matthewmhong/stewart-platform/README.md

# stewart-platform

A 6-RSS (rotary servo) Stewart platform, designed from the kinematics up, built,
and driven from a joystick; the goal is to balance a ping-pong ball on it.  The
repo holds the geometry, closed-form inverse and numerical forward kinematics,
a requirements checker, the Arduino firmware and the PC control code.

<p align="center">
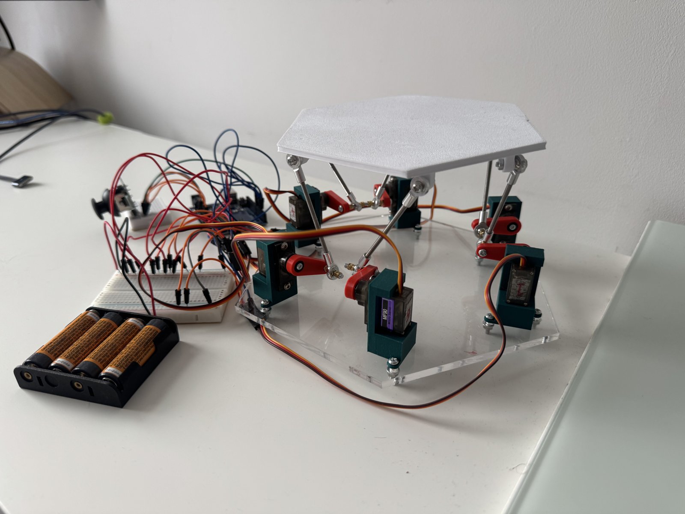
[picture p1: docs/img/build.jpg]
The assembled platform: six servos in green brackets on a clear acrylic base, rods up to a white hexagonal top plate, with the Arduino, joystick, breadboard and AA battery pack beside it
  
</p>

The stage 1 build, October 2026.  The six MG90S servos sit in printed PLA+
brackets on a laser-cut 5 mm acrylic base, and the top plate is printed PLA.
An Arduino Uno reads the joystick and drives the servos from 4× AA.

**Where it stands.** The platform is built and driven from a joystick (stage
1).  The kinematics are done and tested, the servos are bench-measured and
calibrated, and the geometry was chosen because it passes every requirement:

    r_b = 80, beta = 10, delta = 0, r_p = 70, beta_p = 35, a = 22.5, d = 70

Requirements are derived from the ball rather than picked: a 50 mm disturbance
recovered in 0.7 s and held to ±8 mm gives tilt range ≥ 4.5°, tilt precision
≤ 0.25°, tilt speed ≥ 65°/s and loop latency ≤ 70 ms.  `stewart/performance.py`
checks a candidate against those with the real kinematics, plus rod-end
misalignment and part-to-part clearance.

Stage 1 runs IK on the PC and sends six pulse widths to an Arduino over USB
serial.  The first joystick run was on 2 October 2026.  `motion.py` exercises
one degree of freedom at a time.  The measured envelope is roll 9.0°, pitch
9.8° and heave 11 mm, limited by the servos, and yaw 3° and surge/sway 3 mm,
limited by the rod-end cone.  The tilt the plate actually reaches has not been
measured yet, so R1-R3 are still predictions.  Measuring them is next, then
stage 2: a camera and closed-loop balancing.
Details in [STATUS.md](STATUS.md); the reasoning, including the wrong turns, is
in [docs/design-log.md](docs/design-log.md).

<p align="center">
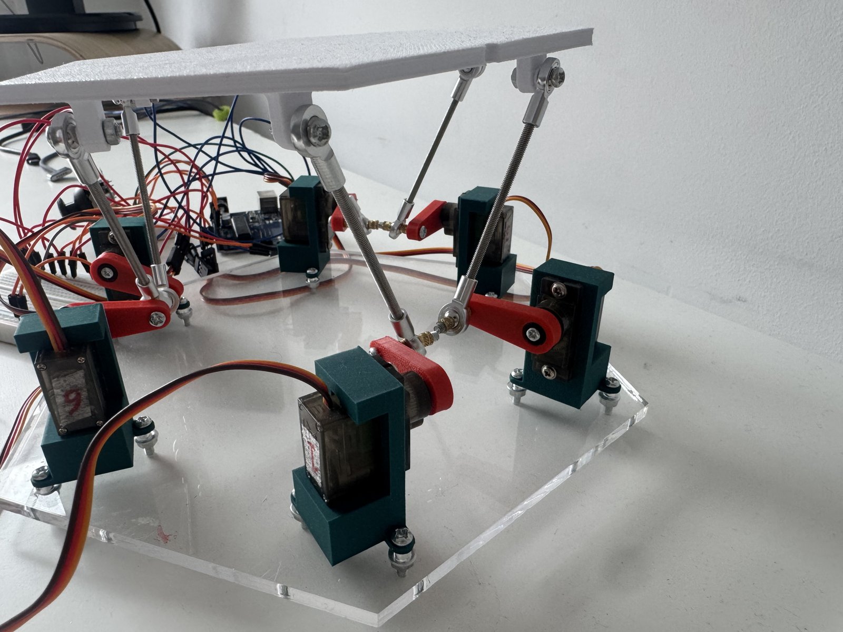
[picture p2: docs/img/build-closeup.jpg]
Close-up of the legs: red printed arms on the servo horns, M3 rod ends spaced off the arms on brass threaded inserts, rods up to the top-plate anchors
  
</p>

Each red arm is printed over the servo's stock horn, so the moulded spline
still sets its angle, and carries an M3 rod end at 22.5 mm.  The brass threaded
inserts on either side of each ball space it off the arm, which lets the joint
swing to about 30° with a straight bolt.

<p align="center">
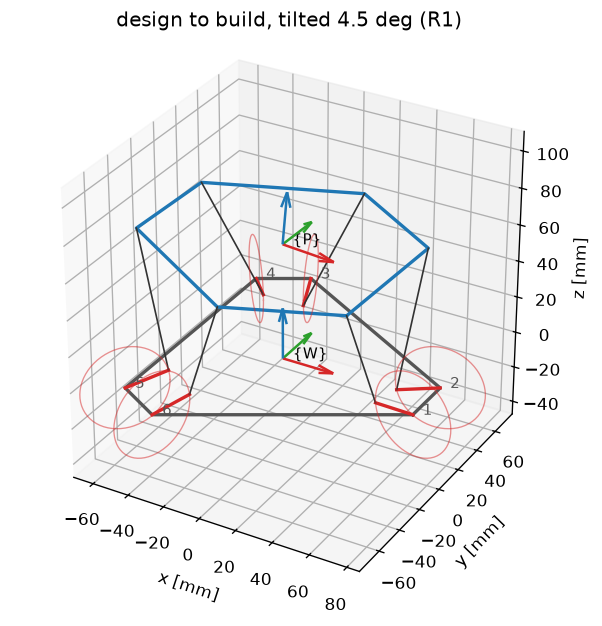
[picture p3: docs/img/design-tilted.png]
The design to build, tilted 4.5 degrees: base ring, servo arms, rods and platform
  
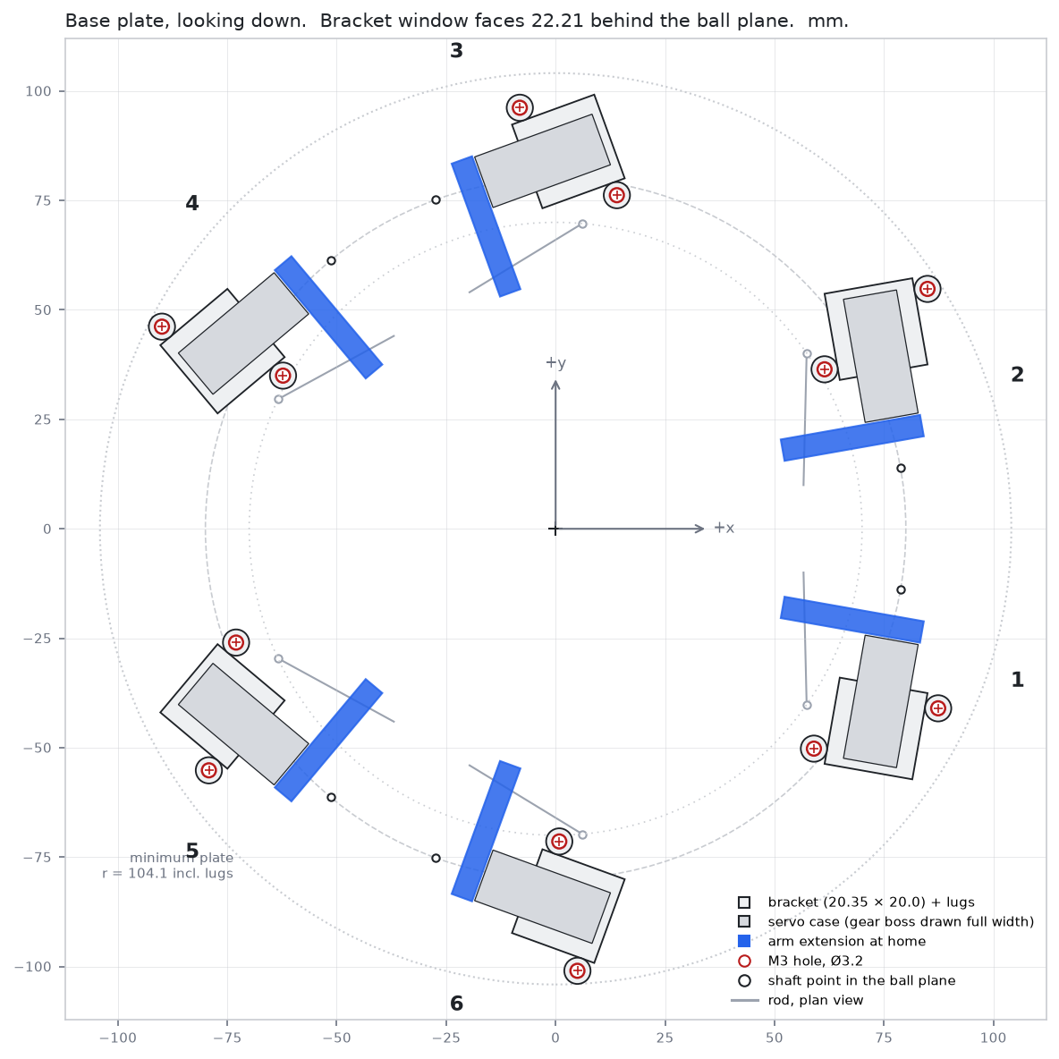
[picture p4: docs/img/base-layout.png]
Base plate from above: six servos in brackets, arm extensions and the twelve M3 holes
  
</p>

Left: the design to build at 4.5° of tilt (R1), from `demo.py`.  Right: the
base plate from above, with servos, brackets, arms and the twelve M3 holes, from
`layout.py`.

## Conventions

- **Millimetres and radians** internally.  Degrees appear only when printing a
  summary or building a servo command.
- **Every anchor array is `(3, 6)`; column `i` is leg `i`.**  Vectors are
  columns and rotations hit from the left: `R @ p`, never `p @ R`.  A `(6, 3)`
  array will broadcast in many places and silently apply the rotation
  transposed, so shapes and unit norms are checked at construction and failing
  legs are named 1-indexed.
- Pose order is `(R, T)` in every signature.
- Python 3, **numpy + matplotlib**; `joystick.py` and `motion.py` also need pyserial.

## Run

    python -m pip install -r requirements.txt
    python test_kinematics.py                  # unit checks
    python demo.py                             # evaluates the design, writes demo.png, round-trips ik/fk
    python layout.py                           # base-plate plan and M3 hole positions -> base-layout.png
    python joystick.py                         # drive the tilt from the joystick (--selftest: no hardware)
    python motion.py                           # oscillate one DOF at a time (--selftest: no hardware)
    python tilt_test.py                        # measure the plate's tilt against commanded (--selftest: no hardware)

## Layout

    stewart/
      geometry.py        Geometry, base_ring, platform_ring, make_geometry
      kinematics.py      stage1, legs, arm_tips, ik, fk (+ Jacobian, solver)
      performance.py     R1-R3, rod-end cone and clearance against one design
      plotting.py        drawing only - never solves kinematics
      roundtrip.py       pose -> ik -> fk -> pose harness
    test_kinematics.py
    demo.py              the design to build: evaluate, draw, round-trip
    layout.py            base-plate plan: servos, brackets, drill holes
    joystick.py          stage 1: joystick -> tilt -> ik -> pulse widths over serial
    motion.py            one-DOF oscillations (roll/pitch/yaw/surge/sway/heave)
    tilt_test.py         holds commanded tilts to read with a level; R1 and R2 on the machine
    firmware/
      servo_test/        Arduino bench-test sketch for one MG90S
      servo_cal/         six-servo calibration: per-leg zero and direction, in EEPROM
      joystick/          streams the stick, outputs the six pulses, fails safe to level
    docs/                derivation, design log, hardware specs, figures
    archive/             frozen: old docs, Phase 0 diagnostics and sweep outputs

## Documents

| file | what it is |
|---|---|
| [STATUS.md](STATUS.md) | requirements, open items, next steps - edited in place |
| [docs/derivation.md](docs/derivation.md) | the maths, and the symbol glossary (§1) |
| [docs/design-log.md](docs/design-log.md) | dated narrative of the design work and why |
| [docs/hardware.md](docs/hardware.md) | specs for the arm extension, servo bracket and top-plate anchors |
| [archive/](archive/) | superseded material, frozen |
