matthewmhong/stewart-platform/archive/README.md

# Archive

Frozen. Not maintained, and may contradict the current docs.

- `docs/` — old session handoffs, one-off Claude Code reports, the repo
  inventory, the full dated notation log, and the 4–10 September design-log
  entries (`design-log-phase0-sweep.md`), and the Phase 0 parts survey that
  used to open `docs/hardware.md` (`hardware-pull-2026-09-09.md`).
- `diagnostics/` — the Phase 0 diagnostic scripts, including the reach-margin
  sweep. They were written as the package `stewart.diagnostics`, so they no
  longer run from here; check out a commit before 2026-09-13 to run them.
- `sweep-outputs/` — the sweep's `.npz`, report and plots (untracked, local
  only).

Superseded on 2026-09-13 by the requirements-driven approach in `STATUS.md`.
For symbols read `docs/derivation.md` §1.
