matthewmhong/stewart-platform/docs/phase-0-design-log.md

# Stewart Platform — Design Log

**Phase 0: kinematics and design method.** A 6-DOF parallel manipulator built as a
ball-balancing platform. Six rotary servos, rigid arms, fixed-length push rods.
100 hours budgeted across the project.

A chronological record of the design work: the reasoning, the decisions and why I
made them, the mistakes, and the results. Dates are the order things were actually
worked out, not a retrospective tidy-up.

---

## 19–20 August

### The decision that shaped the project

The project brief I started from wasn't my own, and I hadn't internalised it.
Tested on six questions about the mechanism at the outset, I could answer none. I
did not know what a pose was, or what a degree of freedom was.

What I decided to do about that shaped everything since. Carrying an unexamined
plan through to a built machine would leave me unable to answer the only question
that matters about a mechanism design: *why this geometry?* A demonstrator I can't
defend is worth less to me than no demonstrator.

So I fixed the method before any of the engineering: derive the kinematics myself,
in symbols, and let the mathematics produce the dimensions — rather than choosing
dimensions and constructing a justification afterwards.

One rule follows from that and I've held to it since: **nothing is purchased and
no CAD is drawn until the geometry sweep has chosen the dimensions.** Every number
in the eventual build has to be traceable to the analysis.

### The mechanism

Six legs connect a fixed base to a moving platform. Each leg is a servo bolted to
the base, a rigid arm on the servo shaft, and a push rod of fixed length running
from the arm tip to an anchor point on the platform. Six servo angles in, one
platform pose out.

A *pose* is position plus orientation: three numbers for where the platform centre
sits, three for how it's tilted. Six inputs, six outputs — hence six degrees of
freedom.

Two frames are needed throughout:

| | |
|---|---|
| `{W}` | World frame. Fixed to the base and the table. Never moves. |
| `{P}` | Platform frame. Attached to the moving plate; tilts with it. |

Labelling every vector with the frame it's expressed in turned out to be the
single most valuable habit I adopted, and its absence caused my first real error.

There's an asymmetry in this class of mechanism worth stating early, because it
shapes the whole approach. For a *parallel* manipulator the inverse kinematics —
pose in, joint angles out — has a closed-form solution, while the forward
kinematics does not and has to be solved numerically. That's the reverse of the
serial-arm case most people meet first.

### Stage 1: locating the platform anchors

The platform anchors are holes in a printed ring. Their coordinates in `{P}` are
fixed design constants, denoted `p_i`. Their coordinates in `{W}` change whenever
the platform moves.

My first instinct was to add the platform centre position `T` to `p_i`
componentwise. Working out why that's wrong was the moment the frame concept
became concrete for me: one unit along the world x-axis is not one unit along the
platform's x-axis unless the platform happens to be level. The two vectors are
measured against different rulers, and the rotation matrix `R` is what reconciles
them — it converts a vector's `{P}` components into `{W}` components.

```
q_i  =  T  +  R p_i
```

I checked it two ways before proceeding. With `R = I` the expression must collapse
to plain vector addition, and it does. With `T = 0` and a 90° rotation about z, an
anchor must swing to a position I can confirm by hand, and it does.

### Stage 2 geometry: circle meets sphere

The servo arm swings in a fixed plane, so the arm tip is confined to a **circle**
of radius `a` centred on the servo shaft.

The push rod is rigid, so the tip is always exactly `d` from the platform anchor —
a **sphere** of radius `d` centred on `q_i`.

The arm tip is wherever the two surfaces meet. Three cases follow, and I worked
out all three geometrically before attempting any algebra:

- **Two intersections** — the general case. The arm can be swung either way to
  place the tip correctly.
- **One** — circle tangent to sphere. The limit of that leg's reach.
- **None** — the leg can't reach. This happens two distinct ways: the anchor too
  far for arm and rod to span between them, or too close, with the circle sitting
  entirely inside the sphere.

The third case is what will define the machine's workspace boundary. Any pose in
which any one leg has zero solutions is a pose the platform physically cannot hold.

### The leg vector, and a productive dead end

This took several attempts and was the hardest part of the first session.

I went looking for a single global reference point for the machine as a whole. I
tried the world origin, then treating the platform as one rigid body, then the
centroid of the six servo positions — which felt clever at the time and leads
nowhere. The reason it leads nowhere is the useful part.

The resolution: **the inverse kinematics is six completely independent problems.**
Leg 3's geometry makes no reference to servos 1, 2, 4, 5 or 6, nor to the base as
a whole. Six separate problems that share only the pose they start from. Leg *i*'s
circle is centred on servo *i*'s own shaft and nothing else.

Once that's established, only two points matter for leg *i*: the anchor `q_i` and
the shaft `b_i`. And since the geometry is unchanged if the whole machine is
carried across the room, what matters is neither absolute position but the vector
between them:

```
L_i  =  q_i  -  b_i  =  T  +  R p_i  -  b_i
```

An important distinction I nearly missed: `|L_i|` is **not** the rod length. It's
the distance the arm and rod have to span *together*. Dividing that span between
them is precisely the stage 2 problem.

### Sizing the problem before solving it

Four quantitative results, produced to establish what the machine actually has to
do before I chose any dimensions.

**Minimum tilt to arrest the ball: 1.635°.** By energy method, for a 200 mm/s ball
brought to rest within 100 mm of travel.

I'm treating that figure carefully. It's a *minimum*, not a design target — what's
required with zero margin, assuming no latency, no friction variation and no
external disturbance. Designing to it is designing to fail. It's a floor to stay
well clear of, and the actual target with justified margin is still mine to set.

**Ball travel during a 150 ms latency window at 300 mm/s: 45 mm.** On a plate of
this size that's a substantial fraction of the working area, which establishes
that control latency is a first-order concern rather than a refinement.

**Worst-case leg force is not a live constraint.** The ball is 2.7 g. No plausible
geometry will leave the servos struggling to support it. I ruled it out early so I
wouldn't spend more time on it.

**The result that most changed how I'm approaching the sweep.** How many
distinguishable tilt steps does the platform have? It's usable servo travel
divided by servo deadband. The geometry ratio — how much platform tilt results
from one degree of servo rotation — appears in both numerator and denominator and
**cancels**.

The consequence isn't obvious and it reframes the whole optimisation: geometry
does not determine how many tilt steps I get. It determines how they're *spent* —
a wide tilt range with coarse steps, or a narrow range with fine ones. There's no
geometry that offers "more control" in the resolution sense; that quantity is
fixed by the servo. The design problem is choosing where to spend a fixed budget
of resolution, which is a very different question from the one I started with.

One process note. Partway through the analysis a 300 mm/s ball speed appeared in
my working with no traceable source. I stopped and asked where it came from rather
than building on it.

---

## 28 August

### Why there is software at all

Before writing any code I wanted to be explicit that the software isn't an
implementation of a finished design. It has three jobs, and only the third
resembles what people usually mean by "the code".

**It's how the geometry gets chosen.** A design sweep means: generate candidate
dimensions, run the inverse kinematics across a grid of poses, score the result,
and repeat some thousands of times. That requires an IK I can *call*. Symbolic
results on paper can't be swept. The Python is therefore a design instrument — the
mechanism by which my derivation becomes the numbers I order parts against.

**It's how I find out the derivation is wrong.** The round-trip test runs a pose
through the IK to six servo angles, then through a numerical forward kinematics
back to a pose. If the pose returns, the mathematics is self-consistent. If it
doesn't, there's a sign or frame error — found now, rather than after I've cut six
push rods to a length computed from a bad equation.

**It's the debugger.** A transposed rotation matrix produces entirely plausible
numbers and a platform that tilts the wrong way. That's visible in one frame of a
3D wireframe and effectively invisible in a column of floats.

### Establishing what is and is not a design variable

The complete list of quantities a leg's inverse kinematics consumes: the platform
anchor positions `p_i`, the servo shaft positions `b_i`, the arm length `a`, the
rod length `d`, and the orientation of each servo's rotation plane. Nothing else
about the machine enters the calculation, so those are my design variables and
there are no others.

I can't sweep them as raw numbers. Six anchors at three coordinates each, twice
over, is thirty-six values before `a` and `d` are counted. A thirty-eight
dimensional search isn't a sweep. The anchors therefore need a *parameterisation*
— a small set of controls that generate all six positions from structure I can
defend. Three or four is tractable; twelve isn't.

Two further distinctions I recorded so I don't conflate them later:

- `a` and `d` are different kinds of variable. `a` is restricted to servo horns
  that commercially exist — a small discrete set. `d` I cut to length myself and
  it's effectively continuous.
- The servo rotation planes are a design variable, not fixed scenery. Which
  direction each servo faces changes what the mechanism can do. Easy to overlook
  because, unlike the others, it isn't a length.

### Conventions

Fixed deliberately and early, since convention errors in this domain are silent:

- **Millimetres and radians** throughout the code. Degrees appear only when
  printing or building a servo command. Units checked on every line — I added a
  rotation to a radius once.
- **Column vectors.** Anchors stored as (3, 6) arrays with column *i* being leg
  *i*. This matters more than it appears: stored row-wise as (6, 3), the
  expression `p @ R` executes without error and returns a result in which every
  value is wrong, because it applies the rotation transposed and tilts the
  platform backwards. No exception is raised. The correct form is `R @ p`.
- **Every equation tested on a known case** at the moment it's written, not at the
  end. `R = I`, `T = 0`, 90° about z.

### Stage 1 in code

```python
return R @ geom.p + T.reshape(3, 1)
```

The reshape is load-bearing. `T` arrives with shape (3,), and numpy would attempt
to align it against the last axis — the six legs — rather than the three spatial
components. Forcing it to (3, 1) broadcasts it across the columns as intended. The
matrix product handles each anchor independently: (3,3) @ (3,6) yields column *i*
as `R p_i`.

Verified against both known cases. `R = I, T = 0` returns the design constants
unchanged; a 90° rotation about z sends an anchor at (10, 0, 0) to (0, 10, 0),
confirming `R` isn't transposed.

The leg vector follows. I wrote it in terms of the stage 1 function rather than
expanding it inline, so a change propagates and there's a single place to make a
sign error:

```python
return stage1(geom, T, R) - geom.b
```

### Locating the arm tip

This is the forward half of stage 2 and the expression the closed form inverts.

The observation that makes it tractable: the arm tip position `h_i` appears to be
three unknown numbers, but it isn't. The tip is confined to a circle, and **a
point on a curve requires one number to specify**. That number is the servo angle
— which is the quantity I'm solving for in any case. The two circle constraints
are therefore not solved but *spent*, collapsing `h_i` from three unknowns to a
function of one.

Writing it down requires a coordinate system inside the servo's plane, expressed
in world components. The plane is tilted in general, so the world x and y axes
won't serve. I need two perpendicular unit vectors lying in the plane:

- `u_i` — the direction I define as `alpha_i = 0`. A free choice.
- `v_i = n_i × u_i` — the cross product with the plane's normal. Perpendicular to
  `n_i` and therefore lying *in* the plane, perpendicular to `u_i`, and of unit
  length because both inputs are unit and mutually perpendicular.

Giving:

```
h_i  =  b_i  +  a ( u_i cos alpha_i  +  v_i sin alpha_i )
```

A conceptual error on the way to this, worth recording because I suspect it's a
common one. I first tried to write the bracket as a coordinate triple,
`(u cos α, v sin α, 0)`. That object doesn't exist. A tuple `(x, y, z)` has
meaning only once the basis its numbers are measured against has been fixed
elsewhere; the basis vectors can't appear inside it. And the zero has nowhere to
live — a third component would require a third basis vector, which would be `n`,
and the tip never leaves the plane. The correct object is a **sum of vectors**,
not a triple.

Verified two ways, the second being the one that matters. Every tip is exactly `a`
from its shaft; and at `alpha = 0`, `h` equals `b + a·u`. The distance check alone
can't detect `u` and `n` being swapped, since `n` is also a unit vector — a tip
placed along it is also exactly `a` away, pointing in an entirely wrong direction.

### The closed form

One constraint remained unused and one unknown remained in it.

**Substituting.** Into `|q_i - h_i| = d`, with `h_i` now a function of `alpha_i`,
and grouping `q_i - b_i` back into `L_i`:

```
| L_i  -  a ( u cos alpha + v sin alpha ) |  =  d
```

Two errors here that I had to be corrected on. First, I read the bars as absolute
value and concluded squaring wasn't permitted. They denote vector **magnitude**,
and `|A| = √(A·A)` — so squaring is precisely what removes the root, cleanly,
since both sides are non-negative. Second, I initially wrote the expansion as
`|A - B|² = A² - B²`, which is the difference of two squares and isn't true even
for scalars. The correct expansion:

```
|A - B|²  =  (A-B)·(A-B)  =  |A|²  -  2 A·B  +  |B|²
```

**Expanding.** Taking `|B|²` first, with `B = a(u cos α + v sin α)`. Multiplied out
as a product of two sums, four terms result; `u·u = 1`, `v·v = 1` and `u·v = 0`
kill the two cross terms, leaving `a²(cos² + sin²) = a²`.

That outcome is forced, and recognising it gives me a check worth keeping. `B` is
the servo arm, and the arm's length is `a` regardless of where it points. Had the
algebra produced anything else, something upstream was wrong.

The middle term:

```
L·B  =  a ( L·u cos alpha  +  L·v sin alpha )
```

`L·u` and `L·v` are scalars — the anchor's coordinates *within* the servo's plane
— computable the moment the pose is known, and containing no `alpha`. Sorting
every term into known and unknown is what made the structure of the solution
visible to me.

Assembled and rearranged with the unknowns isolated:

```
d²  =  |L_i|²  -  2a ( L·u cos alpha  +  L·v sin alpha )  +  a²

M cos alpha  +  N sin alpha  =  P

M = L·u        N = L·v        P = ( |L_i|² + a² - d² ) / 2a
```

**Inverting.** A weighted sum of a sine and a cosine at the same frequency
collapses to a single shifted sinusoid. I didn't accept the identity on assertion
— its derivation is short and worth keeping. Treat `(M, N)` as a point in an
abstract plane, unrelated to the servo's plane, and express it in polar form as
`M = C cos φ`, `N = C sin φ`. That's always possible; it's Cartesian to polar and
nothing is lost. Substituting:

```
M cos α + N sin α  =  C cos φ cos α + C sin φ sin α
                   =  C ( cos φ cos α + sin φ sin α )
                   =  C cos( α - φ )
```

The bracket is the cosine difference identity. The unknown now appears exactly
once and the expression inverts directly:

```
C        =  sqrt(M² + N²)
phi      =  atan2(N, M)
alpha_i  =  phi  ±  arccos( P / C )
```

**A trap worth documenting.** I first wrote the phase as `arctan(N/M)`. Its range
is only (−90°, 90°) — half a turn — and the division discards the sign information
distinguishing `(M, N)` from `(−M, −N)`. Roughly half the servos would be 180° out,
presenting on the bench as an apparent wiring fault. `atan2` retains both signs and
covers the full circle.

**The three cases, recovered.** Everything I'd predicted geometrically now appears
as a condition on `arccos` requiring its argument in [−1, 1]:

| | | |
|---|---|---|
| `\|P\| < C` | 2 solutions | circle cuts sphere twice |
| `\|P\| = C` | 1 | tangent — the workspace boundary |
| `\|P\| > C` | 0 | unreachable |

The algebra produced nothing I hadn't already reasoned out with a pencil, which is
the strongest evidence available to me that both are correct.

### Verification

I checked the closed form by running the problem backwards. Six arbitrary servo
angles chosen; the forward map computes the corresponding arm tips; anchors placed
at exactly `d` from each tip; then the closed form asked to recover the original
angles.

It did, on every leg. Five returned on the negative branch and one on the positive
— not a defect in the formula, but the two-solution ambiguity appearing in
concrete form for the first time.

---

## 1 September

### Why the servo planes needed parameterising first

The sweep needs a candidate geometry described by a handful of numbers. Written
raw, the servo rotation planes are six unit normals — eighteen components, and
they sit alongside eighteen more for the platform anchors and eighteen for the
shaft positions. That isn't searchable.

The second reason is the governing rule of the project. Six independently chosen
normals have no answer to *why this geometry?* A generating rule does.

An ordering constraint I hadn't seen until I tried to start: the normals sit on
top of the shaft positions, so whatever symmetry the base layout has, the normal
rule has to respect it. That means the base layout has to be fixed first. Trying
to write the normal rule before deciding the base pattern is assuming a symmetry
that may not exist, which is why the problem felt like it had no entry point.

### The base ring

Three pairs on a threefold orbit, mirror-symmetric within each pair:

```
s_i      = (-1, +1, -1, +1, -1, +1)
theta_i  = 120·floor((i-1)/2)  +  s_i·beta
b_i      = r_b (cos theta_i, sin theta_i, 0)
```

Two parameters, `r_b` and `beta`. The range is `beta ∈ (0°, 60°)` — open at both
ends, because either end collides adjacent servos. `beta = 30°` collapses to the
regular hexagon, which is a useful limiting case to test against rather than a
default to adopt.

### The rule

```
psi_i  =  theta_i  +  90  +  s_i·delta
n_i    =  (cos psi_i, sin psi_i, 0)
```

One scalar, `delta ∈ [0°, 180°)`, generating all six planes. The alternating
`s_i` is what makes the rule mirror-symmetric within each pair, matching the base.

With the in-plane basis fixed as

```
u_i  =  z × n_i          v_i  =  n_i × u_i  =  z
```

since `n_i` is horizontal.

### The 90° is forced, not chosen

I first wrote it as a convenient reference. It isn't a choice. Putting a general
constant in and imposing the mirror condition on a pair:

```
psi_i  =  theta_i + c + s_i·delta

psi_1  =  -beta + c - delta         mirror:  180 - psi_1  =  180 + beta - c + delta
psi_2  =  +beta + c + delta

equal  =>  c = 180 - c  =>  c = 90
```

Only `c = 90` survives, mod 180. `c = 270` is not a second option — it is the same
planes with every normal flipped, giving identical arm circles with `alpha`
relabelled as `180 − alpha`. That is the `delta ↔ delta + 180` redundancy already
accounted for by the half-open range.

**What it buys.** At `alpha = 0`, the tip is at `b_i + a·u_i`, and
`u_i · z = (z × n_i) · z = 0`, so the tip sits exactly at base-plate level. The arm
lies flat. That corresponds to a servo at mid-travel and gives an unambiguous
assembly datum — arms level, checkable by eye against the plate.

### Horizontal shafts, and what the choice pays for

Constraining every shaft axis to lie in the base plane is a decision, not a
consequence. The obvious benefit is manufacturing: servos bolt flat, no brackets.

The non-obvious benefit is that it removes a whole class of failure. Because
`n_i · z = 0`, the vertical direction lies *inside* every servo plane, so the
vertical component of the leg vector passes into the solution intact:

```
N  =  L_i · v_i  =  L_i · z  =  (q_i - b_i) · z  =  q_i · z
```

using `b_i · z = 0` since the shafts sit in the base plane. So `N` is simply the
height of anchor *i* above the base plate, and since

```
C  =  sqrt(M² + N²)  ≥  |N|
```

`C` cannot reach zero unless an anchor is sitting on the base plate itself. On any
machine where the platform stays above the base, the leg cannot lose authority
through `C → 0`. That is established by construction rather than by searching the
parameter space for degenerate values, and it means no region of `delta` needs
excluding.

Worth recording the dependency: this argument rests entirely on `n_i · z = 0`. If
canted shafts are ever revisited, it disappears and the degeneracy question comes
back open.

### Tuning delta

`delta` is chosen, not fixed by symmetry. The objective:

```
J(delta)  =  max over pose envelope, over i, of  |L_i · n_i|
delta*    =  argmin J on [0°, 180°)
```

`L_i · n_i` is the component of the leg vector perpendicular to the servo's plane
— the part the servo has no authority over. It is pure penalty: it never appears
in `C = √(M² + N²)`, but it does contribute to `|L_i|²` and therefore to `P`. So
out-of-plane offset inflates `|P|` while adding nothing to `C`, pushing legs
toward the unreachable condition `|P| > C`. Minimising the worst case across legs
and poses is minimising the tightest reachability constraint on the machine.

No closed form; a 1-D search. Checked against the quantity actually cared about —
the margin `C − |P|` — across the envelope, and the two track.

One structural consequence. `J` needs `L_i`, which needs the platform anchors. So
`delta` cannot be tuned once and frozen; it is an inner optimisation inside the
sweep, run per candidate geometry. Worth knowing before the sweep is written
rather than discovering it when the sweep is slow.

### A correction to the reachability condition

Working on this exposed an error in how I had been thinking about when a leg can
reach. The intuitive condition is the two-sphere one:

```
|d - a|  <  |L_i|  <  d + a
```

That is necessary but **not sufficient**, because the arm tip lies on a circle,
not a sphere. Decomposing the leg vector into in-plane and out-of-plane parts,
`|L_i|² = rho² + w²` with `w = L_i · n_i`, gives `M² + N² = rho²` — the in-plane
part only. The out-of-plane offset `w` appears in `P` but never in `C`.

Concretely, with `a = 20` and `d = 120`: an anchor at `M = 0`, `N = 0`,
`w = 110` has `|L_i| = 110`, comfortably inside `(100, 140)`, and is unreachable —
`C = 0` while `|P| = 1900`.

This closes the item that had been sitting marked *unverified* in the derivation
document: `|P| > C` does catch both failure directions, but the two-sphere bound
is not an equivalent statement of it and must not be substituted for it in code.

### Errors on the way

The first version of the tuning rule was indexed by leg — a `delta_i` per servo,
derived from the direction each leg pointed at home. That defeats the entire point
of the exercise: six numbers is not a parameterisation. The fix was to keep the
one-scalar family and choose the scalar by optimisation over the envelope, rather
than by a per-leg construction.

---

## 4 September

> **Skeleton only — not written up.** The entries below are the factual record of
> what was established, what was withdrawn, and the residuals. Every point marked
> `TODO(him): reasoning` is where this log's other entries carry an explanation of
> *why*, and that explanation is not written yet. Nothing here is in his voice, and
> nothing here should be read as his account of the session until he replaces it.
>
> Sources: `docs/session-handoff-2026-09-04.md`, `stewart-ik-derivation.md` §8/§9/§10,
> `stewart/diagnostics/zhome_datum.py`, `stewart/diagnostics/branch_check.py`.
>
> **Note on ordering.** Several results below reverse other results from the *same
> day*. Where that happens it is stated, with what was replaced. The reversals are
> not tidied away.

### Implemented

- `stage1`, `legs`, `arm_tips`, `w`, `ik`, `Unreachable` in `stewart/kinematics.py`.
  `c_p` threaded through `platform_ring` and `make_geometry`.
- §7 verification table re-established in `test_kinematics.py`, exit 0. Residuals:
  `stage1(R=I,T=0) == p` → 0; `Rz(90)` on `(10,0,0)` → 6.1e-16;
  `|arm_tips(0) - b| == a` → 5.6e-17; `arm_tips(0) == b + a·u` → 0; control row
  `b + a·n` also passes the distance check → 5.6e-17.
- `w()` repointed from an inlined `L_i` to `legs()`; regression over 4000 random
  poses bitwise identical.
- `TODO(him): reasoning` — why the control row was added, and what it shows that the
  distance check alone cannot.

### Established

- **Branch fixed as `-`** for all six legs, resting on `N_i > 0` under horizontal
  shafts. Closest approach to the branch-merge boundary over the provisional
  envelope: **−5.7e-3 of `C`**. Both supporting diagnostics — the 4365-pose sweep and
  the 720-step precession loop — ran at a **single** `z_home`, and that basis is now
  narrower than it was when the branch was fixed (see *Reopened*).
  `TODO(him): reasoning`
- **`z_flat` closed form** (derivation §9), with `g_i = q_i^{xy} - b_i`,
  `A = beta_p - beta`, `G = r_p e^{iA} - r_b`, `delta_G = arg G`:
  `|g|² = r_p² + r_b² - 2 r_p r_b cos A`,
  `g·u = r_b cos delta - r_p cos(A - delta)`,
  `(z_flat - c_p)² = d² - |g|² - a² - 2 a |g| cos(delta - delta_G)`, positive root.
  **Leg-independence is algebraic** — neither `|g|²` nor `g·u` contains `s_i` — and
  needs no D₃ argument. Verified against `make_geometry`, not a rebuilt ring, over
  540 grid points: leg-independence `max_i - min_i` ≤ **9.948e-14** (1.501e-15
  relative); closed form vs library geometry ≤ **1.637e-11** (2.103e-15 relative);
  `max|u_i·z| = 0` exactly. Round-trip confirmation at the derived height with
  `alpha = 0`, `|q_i - arm_tips(0)_i|` against `d`: worst residual **2.220e-16**.
  `TODO(him): reasoning` — including why the D₃ route was not taken.
- **`alpha` at home is one scalar shared by all six legs** (derivation §10). Follows
  from the two residuals above, not a new measurement. Two consequences recorded: all
  six servos read the same angle at home, a by-eye build check; and a non-zero home
  angle is absorbable by horn mounting angle. `TODO(him): reasoning`
- **Inner `delta` objective is the normalised reach margin** `(C_i - |P_i|)/C_i`,
  maximin over legs and envelope poses, superseding `J(delta) = max|w_i|`. The
  division by `C_i` is required for scale invariance. `delta` is absent from `L_i`,
  so `P_i` is `delta`-free and only `C_i` moves; at fixed leg and pose the margin is
  strictly decreasing in `|w_i|`. The two objectives differ **only in aggregation** —
  minimax over `|w_i|` against maximin over the margin. `TODO(him): reasoning`
- **Precompute feasibility bracket**, available because `P_i` is `delta`-free:
  `C_i ∈ [sqrt(|L_i|² - amp_i²), |L_i|]` with `amp_i = sqrt(A_i² + B_i²)`, giving two
  exact delta-free tests. Only the undecided middle pays 180 `delta` steps.
  `TODO(him): reasoning`
- **Compute is a wash, not a win** — correcting an overstatement made in session. The
  datum path was 273M full evaluations; this path is ~7.6M full plus ~1.4e9 cheap
  scan evaluations. Both near 10¹⁰ flops. 1.4e9 floats is ~11 GB, so the scan must
  chunk over candidates. `TODO(him): reasoning`
- **Symmetry structure of the six `w_i`** as the D₃ stabiliser of the pose, verified
  signed with a negative control. **Closed form for `delta*`**,
  `atan2(-r_p sin A, r_b - r_p cos A) mod 180`. `TODO(him): reasoning`
- **`beta_p = beta` is not a rank hole.** True rod lines `q_i - h_i` give full rank 6,
  `sigma_min` monotonic through `e = 0`, scaling linearly in `a` (log-log slope
  0.992). The rank-3 result was a concurrency artifact of the `q_i - b_i` proxy.
  `TODO(him): reasoning`
- **Tilt target does not scale with the kinematics** — `1/k` against translations'
  `k`, so absolute scale re-enters upstream of the sweep. `TODO(him): reasoning`
  — **MOOT 2026-09-08, not wrong.** The tilt target is decided to be a **fixed
  angle**: the ball surface is a bought sheet decoupled from the anchor ring, so
  `x0 = 80 mm` is a property of the sheet and not of `r_b`. **The `k`-dependence
  this entry establishes no longer exists to be established.** Its conclusion —
  absolute scale enters upstream — survives, but on the bed and on `p`'s
  denominator, not on this. See the 8 September entry and `notation.md` sec.9.

### Decided, reversing an earlier decision the same day

- **`z_home = z_flat` is dropped.** `z_flat` remains an **assembly datum only** and is
  no longer identified with the home pose; **`z_home` returns as an outer sweep
  axis**. This replaces the earlier 2026-09-04 decision that `z_home` was determined
  by the flat-arm datum. Propagated: the sweep is **six** normalised axes, not five —
  `beta`, `r_p/r_b`, `beta_p`, `a/r_b`, `d/r_b`, `z_home/r_b`; **15625** candidates at
  5 points per axis, not 3125; `delta ∈ [0°, 180°)` **restored as sufficient**;
  `z_home`'s range **undecided, with nothing currently supplying one**.
  `TODO(him): reasoning` — this is the entry that most needs it: what the datum bought,
  what it cost, and why the cost was judged the larger.

### Withdrawn

- **"8 of 432 grid combinations produce no valid `z_home`, all at `d/r_b = 0.8`, so
  the harness needs a feasibility guard."** An artifact of holding `delta = 40`. All
  8 are feasible on `[180°, 360°)`; **no geometry among them is infeasible**. The
  feasibility-guard requirement it created is struck in both places it appeared.
  `TODO(him): reasoning`
- **"`z_home` is determined, not free, and the sweep is five axes not six."** Per the
  reversal above. `TODO(him): reasoning`
- **`delta*` as an "exact seed … in the right basin."** Correct statement: `delta*`
  zeroes `w_i` at home — the pointwise quantity both candidate objectives are
  monotone in — **at one pose**. It is not the maximiser of the margin aggregate and
  not the minimiser of `J`. **A seed with no basin claim.** The open test is whether
  the margin's maximiser stays within a bracket of it: a question about aggregation,
  not about the function. `TODO(him): reasoning`

### Recorded so it is not reintroduced

- **The flat-arm datum lifts the gauge that makes `delta ∈ [0°, 180°)` sufficient.**
  §8 justifies the half-open range by `n → -n` giving the same planes, which it does
  — but `u = z × n` flips with it, so `alpha = 0` puts the arm on the opposite side.
  Same machine under a relabelling of `alpha`; **different assemblies under a
  flat-arm datum**. Measured with `z_home = z_flat` imposed: **3 of 432** combinations
  are feasible only on `[180°, 360°)`, all three at a simultaneous four-axis grid
  corner (`beta` min, `beta_p` max, `r_p/r_b` max, `d/r_b` min), **so the boundary
  lies outside the sampled region and its extent is unknown**.
- Also: **`delta*` reduced mod 180 returns to `delta_G`**, which is where
  `(z_flat - c_p)²` is **minimised** — under the datum the closed-form seed pointed at
  the tightest-feasibility `delta`.
- `TODO(him): reasoning` — why this is written down at all: the datum is
  algebraically tempting and will be proposed again.

### Reopened by the reversal

- The `-` branch evidence — the 4365-pose diagnostic and the 720-step precession loop
  — was gathered at **one** `z_home` and must be re-run across the restored axis. The
  branch conclusion is not withdrawn; its evidence base is narrower than it read.
- `N_i > 0` now sets the **lower bracket of the `z_home` axis**, not merely a
  docstring-to-test upgrade. `N_i` at home is `z_home - c_p`; tilt drops the low
  anchors by roughly `r_p sin(tilt)`.
- `z_home`'s range: lower from `N_i > 0`, upper from reach `|P| ≤ C`. `z_flat(delta)`
  remains the natural reference for setting the bracket even though home no longer
  sits on it. **Undecided.**
- Hardware pull gains **servo horn spline tooth count / mounting-angle resolution** —
  it decides whether a non-zero home angle costs anything.
- `TODO(him): reasoning`

### Provenance

- `branch_check.py` — the script behind "8 of 432" and the −5.7e-3 boundary margin —
  was **recovered from a session scratchpad, not from the repo**, and committed as
  `stewart/diagnostics/branch_check.py`. It had never been in git history. This is
  the **third** recorded instance of a documented result with no code behind it.
  **Recovered is not the same as never lost.** `TODO(him): reasoning`

---

## 5 September

> Skeleton only, same terms as the 4 September entries above: facts and
> residuals, no prose, nothing in his voice.
>
> Sources: `docs/notation.md` sec.9/10/12, `docs/session-handoff-2026-09-04.md`,
> and the four modules in `stewart/diagnostics/` named below.

**Envelope specified.** `dxy = 0`, `dz = 0`, `yaw = 0`, tilt limit **10.529 deg**.
Bang-bang recovery: `acc = 4 x0 / tau^2`, `sin(tilt) = 7 acc / (5 g)`,
`x0 = 50 mm` working `+ 30 mm` latency drift, `tau = 0.5 s`, `g = 9.80665`.
Bare requirement **6.558 deg** at `x0 = 50 mm`; the 3.971 deg difference is the
latency margin. Both recorded. `TODO(him): reasoning`

- `tau_L = 150 ms` is **provisional**, inherited from the 300 mm/s figure
  withdrawn 2026-09-03. It carries 30 of the 80 mm and 3.97 of the 10.53 deg.
  Needs sensor frame interval plus servo step response. `TODO(him): reasoning`
- Sensitivity: tilt goes as `1/tau^2`; a 10% error in `tau` moves required
  `sin(tilt)` by ~20%. `tau = 0.45` gives 13.038 deg, `tau = 0.60` gives 7.290.
  `TODO(him): reasoning`

**The `1/k` tilt-scaling result is inverted.** Under the arrest framing (fixed
`v`, `L` proportional to `k`) required tilt goes as `1/k`. Under the recovery
framing now adopted, `x0` scales with `k` at fixed `tau`, so `acc` scales with `k`
and **required tilt scales as `k`** - it *grows* with plate size. The conclusion
survives unchanged (absolute scale enters upstream, `r_b` fixed before the sweep);
the mechanism is the opposite sign. `TODO(him): reasoning`

> **MOOT 2026-09-08, not wrong.** Both this entry and the 2026-09-04 entry it
> inverts assumed **`x0` scales with the plate**. Decided 2026-09-08: the ball
> surface is a **bought plastic sheet on a hub, decoupled from the anchor ring**,
> so `x0 = 80 mm` is a property of **the sheet** and the **tilt target is a fixed
> angle — 10.529 deg at every mechanism scale**. There is no longer a
> `k`-dependence for the two framings to disagree about, so neither is corrected:
> the quantity they argue over does not exist. **ASSERTED, not measured.**
>
> What survives: absolute scale does enter upstream. It enters in **exactly two
> places** — the bed (`r_b <= 90 mm`) and `p`'s denominator (the asserted 80 mm
> `r_b` floor) — and **not** through the tilt target. See the 8 September entry
> and `notation.md` sec.9 and sec.12.

**Envelope is two axes, not four.** `dxy = 0` removes `x` and `y`; what remains is
tilt magnitude and tilt azimuth. Being purely angular it carries no length
dimension and does not scale with `k` at all. `notation.md` sec.9's note about
translations forcing the envelope to scale is deleted. `TODO(him): reasoning`
*(Unaffected by the 2026-09-08 decision above: the envelope was already angular,
and a fixed tilt target is what it was already being read as.)*

**Azimuth window - a claim tested and half-refuted.** Claim: a 60-degree azimuth
window suffices by D3. Measured over the full circle at 0.25 deg, four geometries,
two aggregates, with a negative control (one anchor displaced 0.03 `r_b`):

| invariance | worst relative deviation | verdict |
|---|---|---|
| period 120 | 1.026e-13 | holds |
| mirror `psi -> 180 - psi` | 5.648e-14 | holds |
| mirror `psi -> -psi` | 2.303e-01 | **fails** |
| negative control, period 120 | 6.588e-01 | fails as intended |
| negative control, `180 - psi` | 3.736e-01 | fails as intended |

Width right, position wrong: the window is **`[30, 90]`**, not `[0, 60]`. Mirror
lines in azimuth sit at `30 + 60k`, because a reflection in the plane at azimuth
`m` maps a tilt axis at `psi` to one at `2m + 180 - psi`. `[0, 60]` is symmetric
about its own centre and misses the orbit `{75, 105}` entirely.
`stewart/diagnostics/azimuth_symmetry.py`. `TODO(him): reasoning`

**Pose grid.** 5 magnitudes x 7 azimuths, magnitude 0 counted once:
**29 poses, 174 `w` evaluations** per objective evaluation. Supersedes
`notation.md` sec.9's `3^6 = 729` / `4374` and 2026-09-04's 81 / 486.
`TODO(him): reasoning`

**`z_home` lower bracket, closed form.** `z_home > r_p sin(tilt) + c_p cos(tilt)`
`= 0.182733 r_p + 0.983163 c_p` at 10.529 deg. `delta`-free, `a`-free, `d`-free,
because `v_i = z` exactly and `b_i . z = 0` give `N_i = q_i . z`. Verified against
`make_geometry`: `min N_i` at the bound is 0 to **5.551e-17**; `max |v_i - z|`
**1.110e-16**. `TODO(him): reasoning`

- The back-of-envelope `z_home - c_p > r_p sin(tilt)` drops the `cos(tilt)` and
  overstates by `c_p(1 - cos tilt)` = **1.684e-3** at `c_p = 0.1 r_b`.
  Conservative, so it errs safe; not the bound. `TODO(him): reasoning`
- It is a **continuum** bound. A discrete pose grid reports it satisfied before it
  is - **+5.911e-4** on the 29-pose grid at `beta_p = 25`. The harness must take it
  from the formula. `TODO(him): reasoning`

**`z_home` upper bracket, per candidate, from `|P| <= C`.** No closed form. Over
540 candidates (5 `beta` x 4 `beta_p` x 3 `r_p/r_b` x 3 `a/r_b` x 3 `d/r_b`,
`c_p/r_b = 0.1`), `z_home/r_b` scanned 0.025..3.0 at 0.025, `delta` at 1 deg:

- **363 of 540** have a non-empty bracket; 177 empty; **0 non-contiguous**.
- lower ends `[0.225, 1.650]`, upper ends `[0.425, 1.875]`, widest 0.825.
- empty by `a/r_b`: **144 of 180** at `a/r_b = 0.10`, 33 of 180 at 0.20, 0 at 0.35.
- **`N_i > 0` set the lower end in 0 of 363** - but that is a survivorship sample.
  Attributing the 177 empties (2026-09-05): **176 reach-empty alone, 1 where the
  reach ceiling falls below the `N_i` floor** (`beta=10, beta_p=55, r_p/r_b=1.10,
  a/r_b=0.10, d/r_b=0.80`; ceiling `0.2920624` refined by bisection against a floor
  of `0.29932`, gap **`+7.26e-03`**, real and not a grid artifact). And **6**
  candidates have a non-contiguous *reach* set whose spurious low component
  (`z_home ~ 0.025-0.125 r_b`, platform on the base plate) sits entirely below the
  `N_i` floor in 6 of 6 - so `N_i > 0` is what keeps the feasible set an interval.
  Corrected claim: it does not shape the interior and is not why most candidates
  fail, but it is **load-bearing at the edges** and cannot be dropped.
`TODO(him): reasoning`

**`-` branch re-run across the restored `z_home` axis at 10.529 deg.** Fixture A,
`z_home` swept past its bracket both ways, precession over the full circle at
0.25 deg (1440 steps):

| check | result |
|---|---|
| `min(N_i) > 0`, every `z_home` | passes, worst `+0.896361 r_b` |
| envelope fully reachable | 8 of 15 `z_home`, `[1.2000, 1.2875] r_b` |
| branch reaching `alpha ~ 0` at home | `-`, at every feasible `z_home` |
| branch-flip step outliers | **0** |
| loop closure | `<= 1.78e-15` |
| `max abs(ik() - alpha_minus)` | **8.882e-16** |

`TODO(him): reasoning`

**The `-5.7e-3` boundary margin is superseded.** Reproduced exactly
(`-5.713988e-03`) on the old envelope at the datum `z_home = 1.223343`. On the
settled envelope, same geometry, same height: **`+1.550398e-01`**. Tuning `z_home`
alone at fixture A's untuned `delta = 40`: **`+2.276643e-01`** at
`z_home/r_b = 1.2375`. Individual costs, each a difference of two measurements on
one pose set: yaw `+/-10` **1.8033e-01**, translation `+/-0.05 r_b` **3.6486e-01**,
tilt 6 -> 10.529 **3.6147e-01**. The negative figure was bought by yaw and
translation, not by tilt. `TODO(him): reasoning`

- **WITHDRAWN 2026-09-05: the four-row attribution table.** The decomposition does
  not close - baseline `+5.148872e-01` minus tilt cost `3.614680e-01` gives
  `+1.534192e-01` against a settled figure of `+1.550398e-01`, a **1.62e-3**
  discrepancy, ~1% of the quantity the table existed to explain and three orders
  above every other residual recorded here. Cause confirmed: the rows and the
  settled figure are maximins over **different azimuth samples** (magnitude grids
  identical; 15 deg vs 10 deg), so subtracting one from the other was never valid.
  The conclusion is kept - it rests on gaps of `1e-1`, not on the arithmetic.
  `TODO(him): reasoning`
- **The 29-pose harness grid is grid-optimistic.** Same fixture, same height, by
  azimuth sampling: 15 deg `+1.534192e-01`, **10 deg (the settled figure)
  `+1.550398e-01`**, 0.25 deg reference `+1.531859e-01`. The harness grid
  **overstates the margin by ~1.9e-3**. Same failure mode as the `N_i > 0` bound.
  `TODO(him): reasoning`

**Closed:** handoff open items 1, 5, 8 and 11. `TODO(him): reasoning`

### `fk()` and the round-trip gate — the gate passes

> Same terms as above: facts and residuals, no prose, nothing in his voice.
> Source: `docs/cc-fk-gate.md`, `stewart/kinematics.py`,
> `stewart/diagnostics/roundtrip.py`.

**Gate result.** `pose -> ik -> six angles -> fk -> pose`, seeded **HOME**
(`R = I`, `T = (0,0,z_home)`) at every pose. **14 436 poses, 4 geometries, 3
grid levels.** Worst `|T_fk - T_cmd|` **1.853e-13 mm**; worst
`arccos((tr(R_cmd^T R_fk) - 1)/2)` **2.091e-06 deg**. **0** non-convergences,
**0** different-mode returns, **0** `ik` unreachable. `TODO(him): reasoning`

**Jacobian verified; the handed-over form was correct and was not changed.**
`df_i/dT = e_i^T`, `df_i/domega = -e_i^T [R p_i]_x`, left perturbation
`R -> exp([omega]_x) R`. Central differences, 348 samples, 5 step sizes:

| h (mm) | worst entrywise rel. | worst Frobenius |
|---|---|---|
| 5e-2 | 1.609e-05 | 1.076e-05 |
| 5e-3 | 1.609e-07 | 1.076e-07 |
| **5e-4** | **9.552e-08** | 1.078e-09 |
| 5e-5 | 1.568e-06 | 3.916e-11 |
| 5e-6 | 1.142e-05 | 3.869e-10 |

Bottom of the U at `h = 5e-4 mm`, an order above the textbook
`(eps*scale)^(1/3)`, because `|q-h|-d` cancels two ~120 mm quantities.
Negative control, one pose: sign-flipped left **2.000**, right perturbation
**4.307e-01**, right sign-flipped **1.974**, against **9.781e-10** for the
endorsed form — nine orders, so the test discriminates. `[R p]_x = R [p]_x R^T`,
so the right form differs by an `R^T` as well as a sign. `TODO(him): reasoning`

**The tolerance is an acceptance test, not a stopping rule.** First version got
this wrong. With `tol` as the stopping rule the required demonstration is
structurally impossible: ~40% of poses halt on the first iterate that crosses it
(48 of 117, fixture A at `1e-9`), so a max over a grid is taken over exactly
those, and worst `|dT|` tracks `tol` linearly — **9.7e-10, 1.3e-10, 1.7e-11,
1.8e-12, 1.3e-13 mm** at `tol = 1e-9 .. 1e-13`. `fk` now stops on **stagnation**
and applies `FK_TOL_MM = 1e-9 mm` **once**, to the converged residual. Worst
`|dT|` then **1.2681e-13 mm at every tolerance from `1e-8` to `1e-13`** — zero
movement across six decades. Acceptance fails at `1e-14` (234 poses), which is
below the measured arithmetic floor of **1.4e-14 to 7.1e-14 mm**.
`TODO(him): reasoning`

**Characteristic length not picked; sec.12 stays open.** All `cond` and
`sigma_min` quoted at `r_b` and flagged PROVISIONAL. Worst `cond` over the
coarse grid, by candidate length:

| fixture | `r_b` | `r_p` | `d` | `a` |
|---|---|---|---|---|
| A | 4.183 | 4.175 | 4.20 | 12.81 |
| C | 3.712 | 3.075 | 4.05 | 3.737 |
| E | 7.397 | 6.285 | 6.695 | 7.185 |
| F | 6.317 | 6.365 | 6.54 | 19.51 |

Spread a factor of 3 on F. LM damping is `lam*diag(J^T J)`, not `lam*I`, which
would add a millimetre to a radian and so need exactly that length.
`TODO(him): reasoning`

- Residual-to-pose-error conversion **checked per pose, not asserted**:
  `||dx|| <= sqrt(6)(max_i|f_i| + eta)/sigma_min`, worst measured/bound
  **0.074**. Three corrections were needed: maxima from different poses do not
  multiply into a bound; the bound is on `||f||_2` so `max_i|f_i|` needs
  `sqrt(6)`; and `eta = 8 eps (d + |T|)`, the round-off in *evaluating* a
  residual, must be added — at the floor it is the same size as the residual.
  Without `eta` the check reads **1.535**, i.e. violated. `TODO(him): reasoning`

**Assembly modes are real.** 0 different-mode returns from the home seed. Because
that is equally consistent with "the classifier never fires", the same six angles
were re-solved from **400 random seeds per fixture**: **8 distinct roots each,
32 in all**, every one at the same arithmetic floor (`1.42e-14 mm`) as the
commanded root — **the residual cannot separate them**, which is why the gate
classifies on pose distance. Of 28 non-commanded roots: **1** has all anchors
above the plate, **0** are inside the tilt envelope. The other 27 have
`min q_z < 0`, violating `N_i > 0`. `TODO(him): reasoning`

- A genuine nearby-mode case exists on `smoke_geometry` (`demo.py`'s "yaw +90"
  row): `|dT|` **0.3163 mm**, ang **0.7296 deg**, residual **1.421e-14**, and
  `ik` at the recovered pose returns the **same six angles to 2.0e-13 deg**. It
  sits at `cond` **9045**, `sigma_min` **1.94e-4** (at `r_b = 90`) against `cond`
  4–10 on the real fixtures. Near-singular geometry is where modes coalesce and
  a pose-distance classifier would call a second root a failure.
  `TODO(him): reasoning`

**Grids, and the refinement question.** Coarse/medium/fine at `(5,7,3)`,
`(9,13,5)`, `(17,25,9)` magnitudes x azimuths x `z_home`; coarse is
`envelope.py`'s own 29-pose harness grid. `z_home` sampled in the bracket
**interior**. Worst case **does move** under refinement — 1.47x, 1.14x, 1.29x,
1.46x, monotonic on 3 of 4 fixtures — so a coarse grid flattered it in the unsafe
direction a fourth time. But 40x the poses buying 1.5x in the max is sampling a
fixed round-off distribution at `1e-13 mm`, not finding a worst case. **Open item
12 is unaffected**: this gate has no dynamic range to bear on it.
`TODO(him): reasoning`

**Iteration counts, home seed.** Median **5** on all four fixtures, max **8**,
min 4; cap 100. **Home seed failed to converge at 0 poses** — no basin finding.
LM steps *accepted* 36 / 60 / 246 / 289 of 3600. Counting LM *attempts* instead
reported it on 96% of solves, because every converged solve ends with one
iteration where nothing reduces the residual — that is stagnation firing at the
floor, not a conditioning event, and it would have buried a real conditioning
problem. The home pose is excluded from the statistics and named: at tilt 0 the
seed **is** the commanded pose, so it is the "seeded at the truth proves nothing"
case, unavoidable because home is both the seed and a member of the envelope.
`TODO(him): reasoning`

**Fixtures.** A = `branch_check.py`'s fixture A verbatim, x100. Geometries run at
`r_b = 100 mm` so the tolerance can be a length in mm; the kinematics is
homogeneous of degree one and the envelope is purely angular, so this is a change
of units and `100 mm` remains the 2026-09-03 placeholder, not a decision.

| | β | β_p | δ | r_p | a | d | c_p | bracket (mm) |
|---|---|---|---|---|---|---|---|---|
| A | 20 | 40 | 40 | 85 | 20 | 120 | 10 | `[120.000, 129.000]` |
| C | 10 | 55 | 137 | 60 | 35 | 110 | 20 | `[57.500, 134.750]` |
| E | 50 | 25 | 30 | 60 | 35 | 80 | 10 | `[21.000, 101.500]` |
| F | 45 | 15 | 20 | 110 | 25 | 140 | 5 | `[128.750, 138.750]` |

`TODO(him): reasoning`

**Found on the way, not asked for.** `TODO(him): reasoning`

- **`azimuth_symmetry.py`'s fixtures B and D have empty `z_home` brackets at
  every `delta`** and cannot carry a round trip; E and F replace them in the
  gate, picked for the corners (E at `a/d = 0.44` against A's 0.17; F with
  `r_p > r_b` and the narrowest non-empty bracket found). Its `z_home` column is
  infeasible on **3 rows of 4** — A lists `0.95` against a bracket of
  `[1.2000, 1.2900] r_b`; only C's `0.90` is inside. Does not invalidate that
  module, which tests a symmetry of `w_i` and never calls `ik`.
- ~~**The `arccos` geodesic metric has a `~8.5e-7 deg` floor.**~~ **Fixed
  2026-09-07**, in both places — see the 7 September entry below.
- **`fk`'s stub docstring listed `Unreachable`**, which is an inverse condition —
  in forward kinematics the anchors are what is being solved for and no per-leg
  reach test exists. Replaced by `FKNotConverged(RuntimeError)`. `Unreachable` and
  `ik` are unchanged.
- `fk` returns **`(R, T)`, not `(T, R)`** as specified, because
  `stewart/roundtrip.py` is marked DONE and unpacks `R, T`. **Resolved
  2026-09-07 in favour of `(R, T)`** and recorded as a repo convention in
  `notation.md` — see the 7 September entry below.
- **`README.md`, `CLAUDE.md` and `demo.py` are stale**: the stub list is fully
  discharged, `CLAUDE.md`'s layout table still calls all five kinematics
  functions STUB, and `demo.py` prints "ik/fk stubbed -> every row reports 'not
  implemented'" when nothing is.
- **"Where Phase 0 stands" below is now stale on two points**: the branch rule it
  names as the immediate open question was fixed on 2026-09-04 and re-run on the
  settled envelope above, and the "numerical forward kinematics, a passing
  round-trip test" it lists as remaining are done. Left unedited — it is in his
  voice. `TODO(him): rewrite`

---

## 7 September

> Same terms: facts and residuals, no prose, nothing in his voice.
> Sources: `docs/cc-fk-gate.md` (revised), `docs/notation.md` Conventions and
> sec.12, `stewart/kinematics.py`, `stewart/diagnostics/roundtrip.py`.

Three corrections to the 5 September gate work. **The gate still passes**; none
of the three changes the verdict.

**Rotation metric fixed, not annotated.** The `arccos((tr - 1)/2)` geodesic form
was a spec error and is replaced by `|log_so3(R_cmd^T R_fk)|` — same quantity,
no floor. `arccos` near the identity: `tr(R) = 3 - theta^2 + O(theta^4)`, so the
trace carries the angle at **second order** and an `O(eps)` trace error becomes
`O(sqrt(eps))` in the angle. Floor `sqrt(2 eps)` = **1.21e-06 deg** predicted,
**2.41e-06 deg** measured. The antisymmetric part is **linear** in the angle and
has none. `TODO(him): reasoning`

- **Same quantity, measured not asserted.** Both forms compared against a known
  angle built by `exp_so3` about a random axis, so neither defines the answer:

| true angle (rad) | `\|log\|` rel | `arccos` rel | `\|log\|` abs (deg) | `arccos` abs (deg) |
|---|---|---|---|---|
| 3.11 | 3.19e-16 | 9.57e-15 | 5.68e-14 | 1.71e-12 |
| 1e-2 | 8.91e-15 | 4.59e-12 | 5.11e-15 | 2.63e-12 |
| 1e-4 | 4.87e-13 | 1.75e-07 | 2.79e-15 | 1.00e-09 |
| 1e-6 | 4.60e-11 | 1.07e-03 | 2.63e-15 | 6.11e-08 |
| 1e-8 | 6.97e-09 | 3.22e+00 | 3.99e-15 | 1.84e-06 |
| 1e-12 | 5.35e-05 | 4.22e+04 | 3.07e-15 | 2.42e-06 |
| 1e-15 | 6.23e-02 | 2.98e+07 | 3.57e-15 | 1.71e-06 |

  For angles `>= 1e-2 rad` the two differ from each other by `<= 4.6e-12`
  relative and each matches truth to the same — one quantity, not two.
  `|log_so3|`'s absolute error is `~3e-15 deg` throughout; its relative error
  grows below `1e-12 rad`, which is the **rotation matrix's** limit, not the
  formula's. `TODO(him): reasoning`
- **Effect on the gate:** worst rotation error was reported **2.091e-06 deg**,
  is actually **7.820e-14 deg** — `2.7e7x` lower. Worst `|dT|` unchanged at
  **1.853e-13 mm**. `TODO(him): reasoning`
- Fixed in **both** places: `stewart/kinematics.py` gains `log_so3` and
  `geodesic_angle`; `stewart/roundtrip.py`'s `_geodesic_deg` uses them. Leaving
  one copy floored while fixing the other would be worse than either. Checked:
  nothing else in the project uses the trace form — the remaining `arccos` calls
  are all `arccos(P/C)`, the IK branch. `TODO(him): reasoning`

**`(R, T)` pose order recorded as a repo convention.** Written into
`notation.md`'s Conventions block, so it stops being a per-function question.
Orientation first, everywhere: `stage1(geom, R, T)`, `legs`, `w`, `ik` all
already took it, and `fk(geom, alphas, R0, T0) -> (R, T)` matches rather than
departs. Mnemonic recorded with it: in `q_i = T + R p_i`, `R` is the operator
and `T` the offset, so `R` binds first even though it is written second. Note
sec.2's table lists `T` first — it is a glossary, not a signature.
`TODO(him): reasoning`

**The near-mode case is a SCORING finding, not an FK finding.** `smoke_geometry`,
`cond(J)` **9045**, `sigma_min` **1.94e-4**: a second assembly mode sits **0.32
mm** and **0.73 deg** from the commanded pose, residual **1.42e-14**, and `ik` at
the recovered pose returns **the same six angles to 2.0e-13 deg**.
`TODO(him): reasoning`

- The `ik` clause is what makes it a design problem, not a solver one. Two poses
  0.32 mm apart producing **identical servo commands** are two poses the machine
  cannot distinguish from its own commands — no control law, calibration or
  better solver separates them, because the information is not in the command.
  Which mode it assembles into is set by history, not by the command.
  `TODO(him): reasoning`
- **Nothing in the current feasibility set excludes it.** `|P_i| <= C_i` and
  `N_i > 0` both hold throughout on that geometry, so such a candidate would
  pass feasibility and reach ranking. The four real fixtures sit at `cond` 4–10
  with modes 30–260 mm apart, all below the plate or tilted 50–86 deg.
  `TODO(him): reasoning`
- Argues for `cond(J)` (or `sigma_min`) as a score **discriminator with a
  floor** — hard reject below a threshold, not a term to trade off, alongside
  the reach margin and the translation sensitivity. A weighted sum would let a
  candidate buy its way past a fold. `TODO(him): decision`
  — **Superseded later the same day.** `cond` becomes a cap on the **inner
  `delta` tune**, not a floor on the outer score: a floor reads the candidate
  after the tune has already selected the degenerate `delta`. See *The score
  function — settled* below.
- **Promotes the characteristic length from provisional to blocking.** The
  threshold is a `cond` value; `cond` is undefined until the length is; so the
  length now decides where a **reject line** sits, not just how a ranking sorts.
  Measured spread over four candidate lengths on the gate fixtures: `r_b`
  3.7–7.4, `r_p` 3.1–6.4, `d` 4.1–6.7, `a` 3.7–19.5 — a factor of 3 on one
  fixture at benign values. Recorded in `notation.md` sec.12.
  `TODO(him): decision`
  — **Narrowed later the same day.** With no reject line there is no threshold
  for the length to set, so it **no longer blocks the score**. It stays open for
  quoting `C` and for the FK residual-to-pose bound. See below.
- **Open, and not settled by the above:** whether the right quantity is
  `cond(J)` of the FK Jacobian at all, or the wrench matrix's `sigma_min`, or
  mode separation measured directly. The FK Jacobian is what the gate happened
  to have in hand. `TODO(him): decision`

### The score function — settled

> Same terms: facts and residuals, no prose, nothing in his voice.
> Sources: `stewart/diagnostics/score_discriminators.py`, part numbers cited per
> claim; recorded in `docs/notation.md` sec.8 and sec.12.

**Settled form.**

```
score  =  margin(dxy = p)
```

the maximin normalised reach margin `(C_i - |P_i|)/C_i` over the six legs and the
29-pose envelope grid, evaluated at platform displacement `p`, with `delta` tuned
per candidate to maximise `margin(0)` subject to `cond(J_fk) <= 1e6` at
`char_len = r_b`. Feasibility stays pass/fail before scoring. **`p` is not yet
fixed** — three probes, `0.005`, `0.0075`, `0.010 r_b`, ran side by side and none
was preferred. `TODO(him): reasoning`

**One term, no weights, and nothing to weight.** `sens(p)` is defined as
`[margin(0) - margin(p)]/p`, so `margin - sens(p)*p` **is** `margin(dxy = p)`
identically — **6.9e-18** worst case over the field and all three probes
(part 7). The plan's weighted scalar with stated weights is met by a single
functional with one stated requirement, `p`. `p` is not a weight; it is the build
error the margin is read at. `TODO(him): reasoning`

**`tau_min` is measured-and-redundant.** Spearman `rho = 0.835` against `margin`
over the feasible set (part b). Not weighted into the score, not dropped from the
measurement. `TODO(him): reasoning`

**`cond` is a cap on the inner tune, not a ranking term.** At `C = 1e6` on
`cond(J_fk)` at `char_len = r_b` it catches **exactly** the 34 candidates with
`beta_p == beta` — none outside that set, none of the 34 untouched — costs
**4.87e-5** of margin worst case, and sits **13 decades** clear of the worst
near-miss at `e = beta_p - beta != 0` (parts 2, 5). Reverses the bullet above.
`TODO(him): reasoning`

- **General rule, and it is what the reversal rests on.** A quantity that matters
  and is **not monotone in the pointwise margin** must enter the **inner tune**,
  not the outer score, or the tune will spend it: `delta` is chosen before the
  score is read, so anything the score would penalise is something the tuner
  trades away for margin first, and the score never sees the configuration it
  would have rejected. Two instances now — `cond`, and the tune/score mismatch
  below. `TODO(him): reasoning`

**Tune/score mismatch: real, bounded, left as it is.** `delta` is tuned on
`margin(0)`, the score is `margin(p)`, so every candidate is scored at a `delta`
chosen for a different objective. Worst margin given up **1.37e-3**, below the
ranking grid's own resolution of **2.8801e-3**; maximum rank movement **2
places**; **nothing** enters or leaves the top 20 (part 9). **Re-check if `p` is
taken above `0.01 r_b`** — the bound was measured at and below it.
`TODO(him): reasoning`

**The `|e|` collapse is real, and narrower than it read.** Grouping by
`(r_p, a, d, |e|)`, `e = beta_p - beta`: tuned margins agree within a group to
**1.33e-15**, and still do on a 0.25-degree azimuth grid, 40x finer. Only the
**tuned maximum** collapses — at a **common** `delta` the members' margin fields
differ pointwise by up to **7.81e-1** against a full-field margin range of
**7.93e-1**, and **0 of 124** groups are equal at a common `delta` (part 8). The
members of a group are not the same machine. **The six sweep axes stand**;
`beta` and `beta_p` are sampled independently. `TODO(him): reasoning`

- **CC self-correction 1 — the field comparison was at the wrong `delta`.**
  Comparing each member's margin field at its **own** tuned `delta` compares two
  different configurations, which differ for that reason alone and say nothing
  about the collapse. Redone at a **common** `delta`. That is what turned the
  finding from "the same machine" into "the same maximum only".
  `TODO(him): reasoning`
- **CC self-correction 2 — the single-leg negative control proved nothing.**
  `margin` is a min over legs, so displacing an anchor on a leg that is not
  binding and does not become binding moves nothing, and a control that moves
  nothing tests nothing. Re-run **six times, once per leg**, which separates a
  group the control cannot reach from a group it moves without separating — only
  the second would falsify. `TODO(him): reasoning`
- **The two corrections are why the finding is narrow.** Neither was an
  arithmetic error. Both were controls that, as first written, could not have
  failed. `TODO(him): reasoning`

**Open, and no candidate explanation is verified:** why the tuned maximum
collapses to **1.33e-15** when the fields at a common `delta` differ by
**7.81e-1**. Two different machines, different `margin(delta)` curves, peaking at
the same height to the last bit. Recorded as a property of `max over delta` of
the maximin margin rather than of the geometry at any one `delta` — which locates
it, and is not a mechanism. `TODO(him): decision` — whether it needs explaining
before the sweep runs.

**Open item 12 closes.** Feasibility from the closed forms; ranking from the
10-degree azimuth grid, optimism bounded at **2.88e-3** in margin units. The
second of the two candidate resolutions, taken with the bound used as a
**resolution**: candidates closer together than it are ties, not an ordering. The
uniformity of the optimism across candidates, which the item doubted, is not
assumed. `TODO(him): reasoning`

**The output is a tie set, not a winner.** Top-of-field ties are exact to machine
precision and persist under grid refinement, so no refinement breaks them. They
break on **hardware ranges downstream** — horn set, ball-joint housing OD, rod
stock — not on anything the sweep can compute. `TODO(him): decision`

---

## 8 September

> Skeleton only, same terms as the 4, 5 and 7 September entries: facts and
> residuals, no prose, nothing in his voice, `TODO(him): reasoning` against each.
>
> **Read the ASSERTED marks.** Several entries below are **decisions taken in
> discussion, with no diagnostic behind them**. They are marked **ASSERTED** and
> must not be read back as measured. Nothing here invents support for them.
>
> Sources: `stewart/diagnostics/box_boundary.py` and
> `stewart/diagnostics/tilt_bracket.py`, both committed `fd42513`;
> `docs/notation.md` sec.8 and sec.12.

### THE OBJECTIVE IS INCOMPLETE — an open problem, not a solved one

Source: `box_boundary.py`. The top-5 at every tilt limit sat on **three walls of
the sampled box** — max `a`, min `r_p`, min `d` — so each axis was opened 10
steps of 0.05 `r_b` at the current limit.

**The optimum does not come off the boundary when the box is opened. It moves
further onto it.** `TODO(him): reasoning`

- **`r_p/r_b` runs to `0.10`**, the **smallest value probed**, with margin
  climbing **monotonically to `0.963815`** and **no turn**. The probe ran out of
  steps; the optimum did not run out of descent.
- **Opening `a/r_b` alone moves the winner to `a/r_b = 0.60`** and **drags
  `d/r_b` from `0.80` to `1.20`**.
- **The original corner — `r_p 0.60`, `a 0.35`, `d 0.80` — was an artifact of
  where the grid stopped, not a result.** It is withdrawn as a result.
  `TODO(him): reasoning`

**Diagnosis.** **Margin measures distance from unreachability, not capability.**
A platform ring shrinking toward a point improves it. **Nothing in the score
penalises a mechanism that can barely move.** `TODO(him): reasoning`

**Consequence.** As specified, the sweep returns **the smallest platform whose
ball joints do not collide**, and **every dimension would trace to a housing OD
rather than to the analysis**. That **fails the rule set on 19 August** — nothing
purchased and no CAD drawn until the sweep has chosen the dimensions, every
number traceable to the analysis. `TODO(him): reasoning`

**Options named. None chosen. `TODO(him): decision`**

- **A tilt-authority term.** Moment arm falls with `r_p`, so a fixed servo travel
  buys less platform tilt. **Distinct from the 20 August resolution result**,
  where the geometry ratio cancels for **step count** but **not for range**.
- **Stiffness against the bought sheet.**
- **Fixing `r_p` outright and dropping to five axes.**

**Protocol finding — the stopping rule fired and reversed.** On **two of four
rays** the top-5 lost the extreme value and then **got it back**. On the `a` ray
the rule **would have stopped at `0.50` and been wrong**. **Running all ten steps
regardless is what caught it.** Same failure mode as the 15 / 10 / 0.25-deg
azimuth aliasing recorded on 5 September: **a discrete probe reporting a turn
that is not there.** `TODO(him): reasoning`

**Limitation, recorded with the finding.** Each ray moves **one axis with the
other four pinned at coarse-grid values**, so **a joint optimum needing two axes
to move together is invisible to all four probes**. **The `a` ray pulling `d`
from `0.80` to `1.20` is direct evidence that the coupling is present.**
`TODO(him): reasoning`

### `p` is fixed — ASSERTED, not measured

```
p_mm  =  sqrt(0.2^2 + 0.2^2 + 0.2^2)  =  0.3464 mm
p     =  0.3464 / 80                  =  0.004330
```

normalised by an **asserted `r_b` floor of 80 mm**. Recorded in `notation.md`
sec.8, which supersedes its own "`p` is not yet fixed". `TODO(him): reasoning`

- **Three sources at 0.2 mm**: printer tolerance; ball-joint free play; platform
  centring. **The latter two are placeholders at the printer's figure**, pending
  the hardware pull. `TODO(him): reasoning`
- **RSS, on an independence assumption.** The **worst-case sum of 0.6 mm is
  rejected as unphysical** for three independent sources. `TODO(him): reasoning`
- **`p` scales inversely with the `r_b` floor**, so **raising the floor is safe
  and lowering it is not.** `TODO(him): reasoning`
- **Rod cut tolerance deliberately excluded** — it perturbs `d`, not the platform
  pose. **Checked separately, after `r_b` is chosen**, alongside the already-owed
  `min(C_i - |P_i|)` millimetre check. `TODO(him): reasoning`
- **Consequence:** `p < 0.010 r_b`, so part (9)'s tune/score mismatch bound of
  **`1.37e-3`** carries and **needs no re-measurement**. `TODO(him): reasoning`
- **Residual:** the three probes carried side by side were `0.005`, `0.0075` and
  `0.010 r_b`. **`0.004330` is below all three** — the score has not been
  evaluated at the value now in force. `TODO(him): reasoning`

### Absolute scale — ASSERTED

Recorded in `notation.md` sec.12.

- **Print volume 180 x 180 mm, so `r_b <= 90 mm`.** This is the **upstream
  absolute length**, and **it arrived from the bed, not from torque**.
  `TODO(him): reasoning`
- **The ball surface is a bought plastic sheet on a hub**, decoupled from the
  anchor ring. **Plate radius therefore does not bound `r_p`**, and **`x0 = 80
  mm` survives a bed that could not carry a printed plate of the required
  radius.** `TODO(him): reasoning`
- **`c_p` change from the hub-and-sheet arrangement judged negligible; leg forces
  re-ruled-out with the bought sheet in mind.** The **20 August force ruling
  predates the sheet**, so this is a **fresh judgement, not that one carrying**.
  `TODO(him): reasoning`
- **Consequence for the objective finding above:** the decoupling **removed the
  one physical argument that would have bounded `r_p` from below**, so **the
  runaway is live**. `TODO(him): reasoning`

**The tilt target is a FIXED ANGLE, not a function of plate size.** `x0 = 80 mm`
is a property of **the sheet**, not of `r_b`, so the tilt limit is **10.529 deg
at every mechanism scale**. `TODO(him): reasoning`

- **Withdrawn: the premise that absolute scale enters through the tilt target's
  dependence on plate size.** It is struck in `notation.md` sec.9 and marked at
  both design-log entries that rest on it. `TODO(him): reasoning`
- **Absolute scale enters in exactly two places**: the **bed**, giving
  `r_b <= 90 mm`; and **`p`'s denominator**, the asserted 80 mm `r_b` floor.
  There is no third. `TODO(him): reasoning`
- **The 4 September "tilt target does not scale with the kinematics" and the
  5 September "the `1/k` result is inverted" entries are MOOT, not wrong** —
  marked as such at both sites, with the date and the reason. The
  `k`-dependence they disagree about **no longer exists**; neither is corrected,
  because there is nothing left to get right. `TODO(him): reasoning`
- **Bought-part specification, not a constraint:** the sheet needs a radius of
  **about 110 mm** — contact point out to **80 mm**, ball hanging **20 mm** past
  it, plus edge margin. Recorded **so it is ordered at the right size**. It
  bounds nothing the sweep searches over. `TODO(him): reasoning`

### Servo travel is excluded from feasibility — a decision, not an omission

**ASSERTED.** Feasibility stays the **three** tests: non-empty `z_home` bracket,
envelope reachable, `N_i > 0`. **Recorded so it is not reintroduced.**
`TODO(him): reasoning`

### The `X = 1` crossing is limit-dependent

Source: `tilt_bracket.py`. Recorded in `notation.md` sec.12 beside the
2026-09-05 correction it qualifies.

**The 2026-09-05 attribution — one candidate where the reach ceiling falls below
the `N_i` floor — is what refuted "`N_i > 0` is not binding".** Re-run at
`tau_L` = 75 / 150 / 300 ms (tilt **8.5383 / 10.5290 / 14.5520 deg**), that
category counts **0 / 1 / 2**:

- at **8.54 deg**, `X = 0`, and **the claim stands unrefuted**;
- at **14.55 deg**, **it fails twice**.

**The correction rests on a single candidate at a provisional tilt.**
`TODO(him): reasoning`

**Stated separately — what survives the full range.** **`N_i > 0` never sets the
lower end of a surviving bracket: 0 of 425 / 363 / 259.** `TODO(him): reasoning`

- **The censored margin minimum**, with its caveat: **non-monotone**, because
  **each limit's worst candidate is one about to leave the set**. Not a trend,
  and the three minima are not differenced. `TODO(him): reasoning`
- **The shrinking common set behind `rho = 0.959`** (upward, 14.55 deg;
  `rho = 0.987` downward). Both are over candidates feasible at **both** limits.
  **A high `rho` on a shrinking common set is a weaker statement than the same
  `rho` on a stable one.** `TODO(him): reasoning`

### The tilt limit stays at 10.529 deg

The sweep runs there rather than at 14.55 deg. **The trade, both halves:**
**feasibility is monotone in the tilt limit**, so running at the **higher** limit
would need **no re-check**; running at **10.529** keeps **363 of 540** and median
margin **0.436** against **0.341**. `TODO(him): decision`

- **This creates a re-check obligation.** It belongs in the handoff, **which he
  writes** — not written here.

**Superseded 2026-09-09 by the `tau_L` drop, below — flagged, not rewritten.**
This entry decided to run the sweep at `10.529°` from within a `75`/`150`/
`300 ms` `tau_L` sensitivity range. `tau_L` is no longer in that range; it is
removed. The decision recorded here is preserved as the record of what was
decided and why, on the premise then in force; it is not the decision that
stands now. See the continuation below.

### Continued 2026-09-09 — same 8 September entry, written up the next day

> Skeleton only, same terms as the 4, 5 and 7 September entries: facts and
> residuals, no prose, nothing in his voice, `TODO(him): reasoning` against
> each. Written 2026-09-09, recording decisions dated and asserted 2026-09-08
> together with diagnostics run 2026-09-09 to check them.
>
> **Read the ASSERTED marks**, as above: several entries are decisions taken
> in discussion with no diagnostic behind them, and none is invented here.
>
> Sources: `docs/hardware-pull.md`; `stewart/diagnostics/tilt_authority.py`
> (`3a01bd3`); `stewart/diagnostics/tilt_dropped.py`,
> `stewart/diagnostics/sweep_ranges.py`, `stewart/diagnostics/fixed_ratio.py`
> (all `2af4f3a`); `stewart/diagnostics/box_boundary.py` (`fd42513`,
> referenced, not re-run); `docs/notation.md` sec.8, sec.9, sec.12.

#### `tau_L` is dropped, not revised

Source: `docs/hardware-pull.md`. Recorded in `docs/notation.md` sec.9.

**ASSERTED.** Neither term of `tau_L = 150 ms` is published by any candidate
maker. Servo step response: Hitec, Savox and ROBOTIS each publish
seconds-per-60° no-load speed — a **slew rate**, not a step response — and the
one third-party dynamic study is on two servos that are **not candidates**,
with its ~10 ms delay figure identified by its own author as a **100 Hz
sampling-rig artefact**. Sensor frame interval: published, `4.85`–`33.33 ms`
across the cameras checked, but exposure, readout, transfer and detection are
not, so the term has a floor and no value. `TODO(him): reasoning`

- **Completes the 2026-09-03 withdrawal** of the `300 mm/s` figure `tau_L`
  inherited from — that withdrawal left `tau_L` provisional and unclosable;
  this closes it by removal rather than by a new figure. `TODO(him): reasoning`
- **New limit: `6.558°`**, from `x0 = 50 mm` (working displacement only)
  through `envelope.tilt_for` — the same closed form, called at a different
  `x0`, not restated. Numerically identical to the "bare requirement" row
  recorded 2026-09-05; what changes is that it is now the limit **in force**,
  not a lower reference beside the envelope figure. `TODO(him): reasoning`
- **`envelope.py` still reads `10.529`.** The drop is a documentation entry,
  not yet a code change; every diagnostic that has not explicitly rebound the
  limit still runs at `10.529°`. `TODO(him): decision` — when the code
  changes.

#### Absolute scale: `r_p` fixed, `r_b` fixed exactly, `r_p/r_b` drops out of the sweep

Source: recorded in `docs/notation.md` sec.12.

**ASSERTED, both numbers.** `r_b = 90 mm`, the full print bed — sharper than
the 8 September `r_b <= 90 mm`, which left the exact value open. `r_p = 80 mm`,
from the printed hub carrying the bought `220 mm` sheet — new, not on the
8 September list of two. `TODO(him): reasoning`

- **The sweep is five axes, not six** — `beta`, `beta_p`, `a/r_b`, `d/r_b`,
  `z_home/r_b`. **Not the 4 September "five"**, which dropped `z_home/r_b` and
  was withdrawn the same day; this one drops `r_p/r_b` and leaves `z_home/r_b`
  in. Same count by coincidence, not a reversal. `TODO(him): reasoning`
- **`p`'s denominator was `r_p` under the wrong name.** The `80 mm` `p` was
  divided by, labelled "an asserted `r_b` floor," is this same `80 mm`. `r_b`
  is `90 mm`. `p` recomputed: `0.3464 / 90 = 0.003849`, replacing `0.004330`.
  Same three sources, same RSS argument — only the denominator was wrong.
  `TODO(him): reasoning`
- **This is the option named and chosen from the 8 September list below**:
  "Fixing `r_p` outright and dropping to five axes" was one of three named
  there, none chosen at the time. It is the one taken. `TODO(him): decision`
  — why this one and not a tilt-authority term or a stiffness term; see the
  next entry for why authority specifically was ruled out rather than merely
  unchosen.
- **Fixing `r_p` closed one axis of the runaway. It did not fix the
  objective.** See below. `TODO(him): reasoning`

#### The tilt-authority option is closed, and the reason is the finding

Source: `stewart/diagnostics/tilt_authority.py`, committed `3a01bd3`. Recorded
in `docs/notation.md` sec.12 beside the objective-open paragraph it qualifies.

**`rho(authority, score) = +0.9088`** over the 363 feasible candidates —
authority ranks **with** margin, more strongly than `tau_min`'s already-
recorded `+0.835`. **Negative on all four `box_boundary` rays** (in
`rho(alpha_span, score)` terms: `a` up `-0.2237`, `r_p` down `-0.6251`, `d`
down `-0.2556`, `d` up `-0.9387`). `TODO(him): reasoning`

- **On the runaway axis it agrees with the runaway.** Down the `r_p` ray,
  `0.60 -> 0.10`: best score `0.784 -> 0.951`, winner's `alpha_span`
  **`18.89 -> 1.89°`**. Both readings favour the same shrinking platform.
  `TODO(him): reasoning`
- **Mechanism, part 2b, measured not asserted.** The moment-arm argument
  assumes an envelope commanding a fixed **displacement**; the settled
  envelope is a fixed **angle** (`dxy = dz = yaw = 0`), so anchor excursion
  goes as `r_p sin(tilt)` and **shrinks** with the ring. **General form: under
  a purely angular envelope, no kinematic quantity bounds `r_p` from below.**
  That is why `r_p` was fixed rather than bounded — no term on this envelope
  was going to supply the missing floor. `TODO(him): reasoning`
- **If authority is ever revisited:** the margin-tuned and swing-tuned `delta`
  differ on `349` of `363` candidates, median gap `6°` — it would have to
  enter the **inner tune**, under the same rule `cond` already follows (§8),
  not the outer score. `TODO(him): decision` — not taken here; recorded so it
  is not re-discovered.

#### The objective remains open — restated so the `r_p` decision is not read as having closed it

Two different fixes happened in the same session and must not be read as one.
`TODO(him): reasoning`

- **Fixing `r_p` removed the axis the 8 September runaway was measured on** —
  `r_p/r_b` can no longer run to `0.10`, because it is no longer free.
- **It did not fix the objective.** `margin` still measures **distance from
  unreachability**, not **capability**, on every axis still free. Nothing
  above changes that diagnosis.
- **The tilt-authority option being closed is not the objective being fixed
  either** — it removes one *proposed counterweight*, and leaves the
  imbalance it would have counterweighed exactly where the 8 September entry
  found it.
- **Options still open, restated, none chosen:** stiffness against the bought
  sheet; a term not yet named. `TODO(him): decision`

#### The `N_i > 0` floor binds more than a test that could not fire showed

Source: `stewart/diagnostics/tilt_dropped.py`, committed `2af4f3a`. Recorded
in `docs/notation.md` sec.12 beside the 2026-09-05 survivorship correction.

**`fixed_ratio.py`'s `z_lo <= floor` test is `0` by construction** — the
screen it reads intersects reach with `Z_GRID > floor` strictly, so no
survivor can fail it. The real test, `reach_lo < z_lo` (the reach test's own
lower end, before the floor is intersected in), reads **8** at every one of
four tilt limits checked (`6.558` / `8.538` / `10.529` / `14.552°`).
`TODO(him): reasoning`

- **Same shape, same constraint, second instance.** The 2026-09-05 correction
  found "`N_i > 0` sets the lower end in 0 of 363" resting on a survivorship
  sample; this is a different test, also reporting zero for a reason **built
  into the test**, not the geometry. `N_i > 0` keeps proving load-bearing more
  often than each individual measurement of it suggested.
  `TODO(him): reasoning`

#### Zero-width brackets are a scan artefact, and get a floor

Source: `stewart/diagnostics/tilt_dropped.py`, `2af4f3a`. Recorded in
`docs/notation.md` sec.12.

**21 of 143** candidates feasible at `6.558°` have `z_home` brackets of grid
width `0.000 r_b`. On the **122** candidates common to the `10.529°`
reference, median width **rises** `0.337 -> 0.462 r_b`; the **21 added** by
the lower limit carry median width `0.000` and are what pull the pooled
figure down. The `143`-vs-`122` improvement is **overstated by composition**.
`TODO(him): reasoning`

- **`MINIMUM BRACKET WIDTH = 2 mm = 0.0222 r_b`. ASSERTED**, from build
  tolerance on `z_home`, not measured. Just under one `0.025 r_b` grid step,
  so it removes the 21 and little else past them — a floor, not a
  discriminating filter. `TODO(him): decision` — not applied to the sweep
  here; recorded as a requirement.
- **Fourth recorded instance of a discrete grid reporting something the
  continuum does not.** The other three: the `N_i > 0` bound reporting
  satisfied `+5.911e-4` early (2026-09-05); the 10° tilt-azimuth grid
  overstating margin `~1.9e-3` against 0.25° (2026-09-05/07); `box_boundary`'s
  per-ray stopping rule, which would have stopped early and been wrong on the
  `a` ray (8 September, above). `TODO(him): reasoning`

#### `TIE_TOL` is eight decades wrong at `dxy = p`

Source: `stewart/diagnostics/sweep_ranges.py` part 7, `2af4f3a`. Recorded in
`docs/notation.md` sec.8.

**Measured ranking resolution `~1.5e-4`** at 24 displacement-azimuth
directions (`probe_margin`'s own sampling); refining to 72 and 360 buys
nothing further. `TIE_TOL = 1e-12` is correct for the `dxy = 0` collapse it
was verified against and is **eight decades wrong** as a tie threshold for the
score now in force, which reads at `dxy = p`. `TODO(him): decision` — a
harness requirement, not taken as a code change here.

#### Sweep ranges from the hardware pull

Source: `docs/hardware-pull.md`; `stewart/diagnostics/sweep_ranges.py`,
`2af4f3a`. Recorded in `docs/notation.md` sec.12.

- **`a` is discrete**: 32 published ProModeler hole positions, `9.0`–
  `60.4 mm` = `0.1000`–`0.6711 r_b`. Ceiling is hardware, not sampling;
  Thingiverse extension arms excluded as a print. `TODO(him): reasoning`
- **`a`'s optimum is interior — first axis clean end to end.** Best
  `margin(dxy = p) = 0.847657` at `47.63 mm` (`0.5292 r_b`), holes on both
  sides. `box_boundary`'s `a/r_b = 0.60` pointed at a gap in the ladder, not a
  wall. `TODO(him): reasoning`

  **STALE 2026-09-10, flagged, not rewritten.** This was measured with `d` at
  three values and `beta`/`beta_p` at `10°`/`15°` sampling. With `d` open to
  `2.0` at `0.1` steps and both angles at `2.5°`, the optimum moves to the
  `60.40 mm` hardware ceiling — see the 9 September entry. The pairwise line
  count still turns over near `45.40` vs `47.63 mm`, so this bullet's claim
  about the typical candidate's lean is not itself wrong; only "the optimum"
  moved.
- **`beta_p` bounded both ends of the published `9.0`–`13.0 mm` housing-OD
  range**: `[3.2246°, 56.7754°]` at `9.0 mm`, `[4.6604°, 55.3396°]` at
  `13.0 mm`. No joint chosen. Closes the 2026-09-05 "needs a ball-joint
  housing diameter" open item. `TODO(him): reasoning`
- **`d/r_b` capped at `2.0` (`180 mm`) — ASSERTED**, a judgement about
  slenderness and bow, not a hardware limit; stock runs to `2.1x` that
  length. Both straightness cells NOT RETRIEVED (MISUMI 403; McMaster
  unreachable for a different reason) — the `108 mm` rod at the current
  `d/r_b = 1.20` optimum has no published straightness or buckling figure,
  and that optimum sits on the cell maximum in both directions probed, so the
  wall is untested. `TODO(him): reasoning`
- **`beta`'s range: partially answered.** Body width published,
  `11.4`–`13.0 mm`, and not among the pull's 39 unpublished cells. Installed-
  arc clearance — mounting-flange footprint, screw pitch, inter-body
  clearance — **is** among the 39, for every servo checked. Body width is a
  proxy; the quantity the range actually needs is not published.
  `TODO(him): reasoning`

---

## 9 September

> Skeleton only, same terms as the 4, 5, 7 and 8 September entries: facts and
> residuals, no prose, nothing in his voice, `TODO(him): reasoning` against
> each.
>
> **Read the ASSERTED and PERMISSIVE marks.** Several entries below are
> decisions taken without the figure a full derivation would need, and are
> marked as such. None is invented support; each states what it substitutes
> for and which direction it can be wrong in.
>
> Sources: `stewart/diagnostics/sweep.py` (`e12235c`, `2fee8b0`);
> `stewart/diagnostics/tau_transmission.py` (`227927d`); `docs/notation.md`
> sec.8, sec.12.

### THE SWEEP RAN AND RETURNED A SHORTLIST — the `[CC]` item Phase 0 was built for

Two runs.

**`e12235c` — `beta` unbounded.** `368,000` screened, `327,604` feasible
(`89%`), all scored. Screen `1,449 s`, tune + score `4,295 s`. Tie set of six
on the `(a, d, |e|)` key. `TODO(him): reasoning`

**`2fee8b0` — `beta` bounded** (below). `368,000` screened, `327,780`
feasible (`89.1%`), all scored. `TODO(him): reasoning`

**THE RESULT, from `2fee8b0`:**

```
a       60.40 mm  (0.6711 r_b)   — PDRS60-25T outermost hole
d       126 mm    (1.40 r_b)
beta    5 deg,  beta_p  52.5 deg
z_home  95.62 mm
margin(dxy = 0.003849) = 0.874876,  tie floor 0.874726
```

Two candidates, a mirror pair, identical at **both** housing bounds. Platform
anchor separation clears the full published `9`–`13 mm` housing range. Both
members interior in `beta` with `2.71 mm` of arc slack. `TODO(him): decision`

- **Screen statistics.** `X = 2,819` (reach ceiling below the `N_i > 0`
  floor), answering the sec.12 question left open at `6.558°`. `W = 12,078`,
  **all** at exactly zero width, so the asserted `2 mm` floor removed
  precisely the artefacts it was asserted for and nothing else.
  `TODO(him): reasoning`
- **`89%` feasible is not comparable to the coarse grid's `67%`** — that grid
  swept `r_p/r_b` to `1.1` and most old empties were there. `TODO(him):
  reasoning`

### `beta` WAS BOUNDED, REVERSING THE 8 SEPTEMBER DECISION TO SWEEP IT UNBOUNDED

Source: `stewart/diagnostics/sweep.py`, `2fee8b0`. Recorded in `docs/notation.md`
sec.12, the "`beta`'s usable range" entry.

**Bound `[4.1380°, 55.8620°]`, derived from `arc = r_b * gap` against the
largest published sub-micro CASE SIZE, `13.0 mm`** (hardware-pull sec.5,
MFR, Hitec HS-5085MG / HS-5087MH). Both endpoints land at exactly `13.00 mm`
of arc; both collision ends — `beta -> 0` closing a pair on itself,
`beta -> 60` closing it on its neighbour — checked separately.
`TODO(him): reasoning`

- **PERMISSIVE, and this is why.** Case size is the bare body; the installed
  footprint — flange span, screw pitch, inter-body clearance including
  wiring — is unpublished for every servo checked and is among the pull's 39.
  Flanges and wiring only ADD, so the bound **cannot have excluded anything
  buildable**, and it **tightens, never loosens**, when the missing figure
  exists. `TODO(him): reasoning`
- **`beta` was NOT carrying the answer.** The leader moved `+4.9e-7`; the
  excluded `beta = 2.5 / 57.5` members had already scored below it. The open
  axis was inflating the tie set's SIZE, not producing its winner. **The
  `e12235c` failure was weaker than it read at the time.** `TODO(him):
  reasoning`
- **Amend `notation.md` sec.12** — done, below: "`beta`'s usable range" is
  bounded permissively at case width, not closed.

### THE GROUPING KEY WAS WRONG AND IS CORRECTED

Source: `stewart/diagnostics/sweep.py`, `2fee8b0`. Recorded in `docs/notation.md`
sec.8, the `(r_p, a, d, |e|)` collapse bullet.

**`(a, d, |e|)` is not a complete invariant.** Measured on the sweep:
`48,930` groups, worst spread `3.74e-2`, `10,338` over `TIE_TOL`. The MIRROR
half is exact (`(beta, beta_p) -> (60-beta, 60-beta_p)`); `|e|` alone is not,
because the absolute `beta` enters the score. `TODO(him): reasoning`

- **Corrected key `(a, d, beta, beta_p)` reduced up to the exact mirror:**
  `164,181` groups, worst spread `1.62e-4`, ONE group over `TIE_TOL`. Tie set
  `2` rather than `4`. `TODO(him): reasoning`
- **Part (8)'s key was established at `10°`/`15°` sampling; `2.5°` is the
  first grid fine enough to separate it.** A better measurement correcting
  an earlier one, not a reversal. `TODO(him): reasoning`
- **Amend `notation.md` sec.8** — done, below: the `(r_p, a, d, |e|)` key is
  marked superseded, not deleted.

### THE MIRROR/BRANCH FINDING — its own item, not a grid artefact

Source: `stewart/diagnostics/sweep.py`, `2fee8b0`. Recorded beside the
4 September branch decision and in `notation.md` sec.12's discrete-grid list.

**The one remaining over-`TIE_TOL` group was first attributed by CC to
1-degree `delta` quantisation. THAT ATTRIBUTION WAS WRONG, and CC withdrew
it:** `DELTA_GRID` is `{0..179}`, already closed under
`delta -> 180 - delta`, so a mirror-symmetric grid is a no-op and refinement
cannot remove a spread the grid never caused. `TODO(him): reasoning`

- **The actual mechanism.** The mirror is a rigid `60°` rotation (`b_i`,
  `p_i` match to `6e-16`) but `n_i -> -n_i`, which flips `u = z x n`, so the
  fixed MINUS branch selects the **opposite arm configuration** — arm-tip
  residual `~1.0`. `margin` is branch-independent and mirrors to `1e-15`;
  `cond(J_fk)` is branch-DEPENDENT and mismatches by up to `9.6e3` relative,
  so the cap admits different deltas on the two mirrors. `TODO(him):
  reasoning`
- **Residual: median `0`, p95 `9.4e-16`, max `1.62e-4`, `1` group of
  `163,599`.** CC deliberately did not force the mirrored delta onto its
  partner, because doing so would report a candidate admissible at a
  configuration whose `cond` exceeds the cap — worse than the spread it
  hides. `TODO(him): decision`
- **TWO MIRRORS ARE ONE LINKAGE AND ONE SCORE BUT NOT ONE MACHINE TO BUILD.**
  The arms sit on opposite sides. **The branch rule was fixed as MINUS on
  4 September without this in view.** `TODO(him): decision`
- **Filed as its own kind, NOT a fifth instance of the sec.12 discrete-grid
  pattern.** The other four are resolution problems in a derived quantity on
  a grid too coarse to see an interval. This is a symmetry the solver breaks
  that the geometry does not — a different failure. `TODO(him): reasoning`

### `tau_min` DOES NOT BOUND `a` FROM ABOVE

Source: `stewart/diagnostics/tau_transmission.py`, `227927d`, over the
`2fee8b0` feasible set (`327,780` candidates).

**Whole set:** min `0.218`, median `0.869`, max `0.992`. Per `a`, the median
RISES from `0.60` at `9.00 mm` to a peak `0.912` near `40 mm`, then eases to
`0.899` at the `60.40 mm` ceiling — a `1.3%` give-back, not a collapse.
`TODO(him): reasoning`

- **`rho(tau_min, margin(p)) = +0.626` overall, `+0.485` to `+0.526` at
  `a >= 45 mm`.** Positive throughout, NOT reversed at the top of the range.
  Weaker than the `+0.835` recorded at the old `a <= 0.35` ceiling, same
  sign. `TODO(him): reasoning`
- **At the leader's own geometry with `delta` re-tuned, `tau_min` is
  monotone RISING with `a`, `0.189 -> 0.815` over the `20` reachable rungs**
  — the OPPOSITE of the transmission-degradation hypothesis that motivated
  the check. `12` of `32` rungs are unreachable at that fixed `z_home`.
  `TODO(him): reasoning`
- **With `z_home` and `delta` fully re-derived it is not monotone at all:**
  peaks `0.914` near `32.54 mm`, eases to `0.815` at `60.40 mm`, never below
  `0.526`. `TODO(him): reasoning`
- **Methodology note.** The first verification gate sampled `30` random axis
  draws and found `4` reachable. CC judged that too thin, replaced it with a
  gate drawn from `200` real feasible candidates (`0` disagreements), and
  discarded the weak gate's report rather than letting it stand.
  `TODO(him): reasoning`

### `a` IS ON THE HARDWARE CEILING, AND THAT IS NOW THE STANDING STATE OF THE RESULT

`60.40 mm` is the top of the published ProModeler ladder. **It is not an
artefact of the unbounded `beta` — it survives the bound.** `TODO(him):
decision`

- **`notation.md` sec.12's "`a`'s optimum is INTERIOR ... the first axis to
  come out clean end to end" is STALE** and is marked so below: that was
  measured with `d` at three values and the angles at `10°`/`15°`; at `0.1`
  in `d` and `2.5°` in both angles the optimum moves to the ceiling. The
  pairwise line count still turns over at `45.40` vs `47.63 mm`, so the
  typical candidate still prefers a mid-range hole — the lean and the best
  candidate now disagree, and both stand. `TODO(him): reasoning`

**THE GENERALISATION, and it is the entry's second most important line
after the result itself.** Three axes have now had their limit set by
hardware or by decision and never by the objective:

- `r_p` — no kinematic quantity bounds it under a purely angular envelope
  (8 September).
- `beta` — servo bodies (above).
- `a` — the catalogue, with `tau_min` checked and found not to bound it
  (above).

**That is not three findings. It is one property of reach margin, measured
three times. The objective stays OPEN, and this is the strongest statement
of it yet.** `TODO(him): decision`

### LEDGER CORRECTIONS, both wrong in the direction that would have hurt

Source: measured live during `e12235c`'s run; carried into the printed
ledger in `2fee8b0`.

- **Tune + score timing: `13.1 ms` per survivor measured against `3.8 ms`
  projected**, because the projection calibrated on random axis draws where
  most candidates never reach `probe_margin`. Counts were right.
  `TODO(him): reasoning`
- **Memory recount `92.2 GB`, LARGER than the old `3.9 GB` estimate, not
  smaller.** `TODO(him): reasoning`

### STILL OWED — recorded as such, not done here

- ~~`min(C_i - |P_i|)` in millimetres against the build stack, pass/fail,
  owed since the score was fixed in normalised units and unreachable by a
  normalised ranking.~~ **DONE, below - PASS.** `TODO(him): decision`
- ~~The `126 mm` rod against stock diameter and straightness, both cells NOT
  RETRIEVED.~~ **DONE, below - PASS.** `TODO(him): decision`
- ~~The document batch: pairing argument, `h_p -> c_p`, Grubler, derivation
  renumber, the `arccos` metric floor, `fk()`'s `(R, T)` convention into
  `notation.md`.~~ **DONE 2026-09-10, below.** `h_p -> c_p` renamed at every
  call site, `test_kinematics.py` and `demo.py` both re-run and passing;
  Grubler-Kutzbach added to the derivation as §11, CC-derived and unverified;
  the derivation renumbered contiguous, 1-11 then Appendix, every citing
  cross-reference updated; the `arccos` floor and the `(R, T)` convention
  were BOTH found already fixed (2026-09-07) and are confirmed closed, not
  redone; the pairing argument could not be honestly restated and is left
  flagged, not guessed. `TODO(him): decision`

### Continued 2026-09-10 - two checks the normalised score cannot see, closed

Source: `stewart/diagnostics/build_margin.py`. Recorded against the
`2fee8b0` shortlist: `a = 60.40 mm`, `d = 126 mm`, `beta = 5 / 55 deg`,
`beta_p = 52.5 / 7.5 deg`, `z_home = 95.625 mm`, at `r_b = 90 mm`,
`r_p = 80 mm`, `c_p/r_b = 0.1`, tilt limit `6.5580 deg`. Both mirror
members. Neither check is a ranking; both are PASS/FAIL. No rod, joint or
servo chosen; `notation.md` not touched.

#### CHECK 1 - REACH MARGIN IN MILLIMETRES.  PASS

**`min(C_i - |P_i|) = 90.96 mm`**, both members, worst over legs and the
29-pose envelope grid at the tuned `delta_con` - `263x` the `0.3464 mm` RSS
build-error stack (`notation.md` sec.8, transcribed, not recomputed).
`TODO(him): reasoning`

- **Region, not winner.** Same computation on the next 7 groups below the
  shortlist: `90.5` - `91.8 mm` for groups 2-6, dropping to `89.3` and
  `81.4 mm` at groups 7-8 - still two orders of magnitude clear. The margin
  is a property of where the sweep is ranking, not a special feature of the
  leader alone. `TODO(him): reasoning`
- **Rod cut tolerance has NO published figure anywhere in the pull, and had
  never been checked against anything until this.** Inverted instead:
  solving `|P(d)| = C` EXACTLY (not a linear approximation - the
  perturbation is not small relative to `d`), the margin is exhausted at
  `d -> 163.90 mm` or `43.13 mm`, i.e. a cut error of **`37.9 mm`** on a
  `126 mm` target - not a tolerance failure on any process, a different
  design. `TODO(him): reasoning`
- **A gate-design mistake, caught and corrected before the number was taken
  as final.** The first verification compared this mm-scale minimum against
  the cached NORMALISED `margin_con` and failed on 4 of 20 random
  candidates - not a bug in the reach-margin computation (an independent
  `u, v`-basis re-derivation agrees with the `n`-basis one at 0/20), but a
  wrong reference: `margin_con` is the minimum of `(C-|P|)/C`, whose worst
  point need not be the same point that minimises the UNNORMALISED
  `C - |P|` this check reports. Replaced with the correct cross-check
  before reporting. `TODO(him): reasoning`

#### CHECK 2 - ROD SLENDERNESS.  PASS at every published diameter

`d/r_b = 1.40` inside the asserted `2.0` cap; `hardware-pull.md` sec.7
gives NO elastic modulus for any listed stock and NO straightness/buckling
figure except A286 (`<=2 mm/m`). Euler buckling (`K=1`, pinned-pinned - both
rod ends are ball joints) at every published diameter, against the actual
worst-case axial rod force from the 2.7 g ball's weight alone, solved as
parallel-mechanism statics (`J_fk^T f = -W_ext`, `J_fk` unmodified from the
FK-residual Jacobian; verified against an independent force-and-moment
recomputation, not by re-checking the linear solve, worst residual
`7.7e-15`). **Worst leg force `37.7 mN`.** `TODO(him): reasoning`

- **PASS at every diameter, by at least `19x`** (the thinnest carbon
  pushrod, `0.76 mm`, at the LOW end of an assumed `70-170 GPa` modulus
  range) **up to tens of thousands x** for the larger stock. Closes the 19
  August / 8 September judgement calls with a number rather than a fourth
  judgement. `TODO(him): reasoning`
- **`E` is NOT a hardware-pull quantity for any stock**, and is flagged as
  such at every use - standard published values (`200 GPa` steel, `201 GPa`
  A286, `70-170 GPa` carbon fibre), not pull-sourced. `TODO(him):
  reasoning`
- **What bow would have to be before it matters**, since no straightness
  figure exists for the shortlist's own stock class: a chord-shortening of
  `37.9 mm` (same threshold as check 1's cut-tolerance figure, both being an
  error in the rod's effective end-to-end span) implies a circular-arc
  sagitta of **`42.3 mm` over a 126 mm rod** - not a "straight" rod by any
  measure. The ONE published straightness figure that exists at all,
  A286's `<=2 mm/m`, bowed to its FULL rated tolerance over `126 mm`, would
  shorten the chord by `1.3e-3 mm` - four orders of magnitude below where
  it would start to matter. `TODO(him): reasoning`
- **Platform self-weight is NOT included and remains a separate, larger,
  unspecified load** - no material or mass has been chosen for the
  platform. This closes the BALL's contribution only, matching the 19
  August framing exactly; it does not close the leg-force question in
  general. `TODO(him): decision`

---

**Superseded — 2026-09-10.** Flagged stale once already, above (the entry
between the 5 and 7 September sections): the branch rule this names as the
immediate open question was fixed 2026-09-04, and the numerical FK and passing
round-trip test it lists as remaining are both done. That flag did not say
where to look instead; this does. The sweep has since run twice (`e12235c`,
`2fee8b0`) and returned a shortlist, tau_min has been checked against it, two
build-margin checks have passed, and the document batch above is closed. Read
the 9 September entry above for the current state; this section is left
exactly as written, in his voice, per `TODO(him): rewrite`.

## Where Phase 0 stands

The inverse kinematics is derived and verified. The frame conversion, the leg
vector, and the forward arm-tip map are implemented and each tested against known
cases. The base ring and the servo rotation planes are parameterised — two
scalars for the ring, one for the planes, all three with stated ranges and a
symmetry argument behind them. Nothing has been purchased, no CAD drawn, and no
dimensions chosen — which is the intended state, since the dimensions are an
output of the analysis rather than an input to it.

My immediate open question is the branch rule. The closed form yields two valid
arm configurations per leg and the solver has to select one. The selection has to
be a function of the commanded pose alone: a rule that depends on what was
previously commanded would return different angles for the same pose depending on
history, which breaks the round-trip test and makes any design sweep
irreproducible. The failure mode I'm designing against is a platform following a
smooth trajectory while one leg's rule flips mid-motion, snapping that servo
through a large angle instantaneously — detectable as a step in one servo trace
while the other five stay smooth.

Beyond that, Phase 0 completes with a numerical forward kinematics, a passing
round-trip test, a formal degree-of-freedom check, and the design-objective work
that turns the geometry sweep from an open search into a sorted one: a justified
tilt target with margin above the 1.635° floor, a scoring function, servo
candidates whose travel and deadband feed the resolution analysis, and the anchor
parameterisation. The sweep then selects the dimensions, and only then does
anything get ordered.
