matthewmhong/stewart-platform/(commit log)

2026-09-01 Scaffold 6-RSS Stewart platform design project
    Frozen Geometry dataclass with construction-time shape / unit-norm /
    orthogonality checks (failing legs named 1-indexed); base_ring() fully
    implemented and transcribed from a finished derivation. Everything else
    stubbed: geometry.platform_ring / make_geometry, and kinematics
    stage1 / legs / arm_tips / ik / fk raise NotImplementedError with full
    docstrings (the ik docstring records the |P| > C reachability test and
    why np.clip and the two-sphere bound are wrong). plotting.py and
    roundtrip.py are complete and operate purely on points; roundtrip's
    FK seed is deliberately offset from the truth. demo.py runs end to end
    against the stubs and writes de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
    [demo.py, geometry.py, kinematics.py, plotting.py, roundtrip.py]
2026-09-04 Add Phase 0 design documents
    Four working documents that the code has been written against but which
    were never tracked:
    - phase-0-design-log.md chronological record of the design reasoning
    - stewart-ik-derivation.md the IK derivation; sec.3-5 are what ik() implements
    - notation.md every symbol in one place, with provenance and
    the live name clashes in sec.11
    - leg_diagram.excalidraw leg geometry sketch
2026-09-04 Thread h_p through the platform ring
    platform_ring hard-coded z = 0, so the anchor plane could not be offset
    from {P}'s origin:
    p_i = (r_p cos phi_i, r_p sin phi_i, -h_p)
    New h_p parameter on platform_ring and make_geometry, both defaulting to
    0.0 so existing callers are unaffected. The ring assert now checks the
    in-plane radius and the anchor plane separately, since |p_i| is no longer
    r_p when h_p != 0.
    Also corrects the rationale on the beta_p guard. The open interval is a
    HARDWARE exclusion - two ball-joint housings cannot occupy one hole - not
    a degeneracy one. beta_p -> 0 is the 3-6 Stewart platform, a real
    architecture; the rank collapse once claimed there was disproved on
    20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
    [geometry.py]
2026-09-04 Implement kinematics through ik(), and re-establish the sec.7 table
    Fills four of the five stubs. fk() is deliberately left stubbed; nothing
    beyond ik() is in scope here.
    stage1(geom, R, T) -> (3,6) q_i = T + R p_i
    legs(geom, R, T) -> (3,6) L_i = q_i - b_i
    arm_tips(geom, a) -> (3,6) h_i = b_i + a(u_i cos a_i + v_i sin a_i)
    ik(geom, R, T) -> (6,) alpha_i = phi_i - arccos(P_i / C_i)
    w() now takes L from legs() instead of the copy inlined while legs was a
    stub. Verified bitwise identical over 4000 random poses, and the
    2026-09-03 symmetry and branch checks reproduce digit-for-digit.
    Two departures from the stub signatures, both deliberate:
    - stage1 took (ge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
2026-09-04 Move design documents into docs/, and record the 2026-09-03/04 results
    Structural: notation.md, phase-0-design-log.md and stewart-ik-derivation.md
    move to docs/. Lowercase is deliberate - the directory was created as
    Docs/, which resolves locally only because core.ignorecase is true on
    macOS and would not resolve on a case-sensitive filesystem. Adds the two
    session handoff documents, which had not been tracked.
    Content, in the same commit because the edits travelled with the files:
    notation.md
    sec.4 plate offset settled 2026-09-03. Origin of {P} on the plate top,
    or one ball radius above it when commanding the ball-centre plane;
    anchors coplanar, so all six share on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
2026-09-04 Retract the affine rank-3 claim in make_geometry's docstring
    The docstring stated that beta_p == beta makes the anchors an affine image
    of the shafts spanning only three of six wrench dimensions, and that the
    test could not be written until a solver and a branch rule existed. Both
    halves were false. ik() now exists with a fixed branch, and the result
    does not hold.
    Measured 2026-09-04 with the true rod lines q_i - h_i: full rank 6 at
    beta_p == beta, with sigma_min increasing monotonically through
    e = beta_p - beta = 0 - not a dip, not a local minimum. It scales
    linearly in the arm length, sigma_min / a near 0.93 across a 14x span of
    a, so the rank is bought by the arm and degenerates onl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
    [geometry.py]
2026-09-04 Transcribe three sec.4 items the handoff settled but notation.md dropped
    Diffed the earlier sec.4/11/12 edits against docs/session-handoff-2026-09-03.md,
    which was not tracked when they were written. No settled point disagreed;
    three were recorded incompletely.
    - Plate top: the reason was missing. It is chosen "because that is the
    surface the control law reasons about", and the anchor-plane alternative
    is explicitly tempting-and-wrong - p_i,z = 0 gives tidier algebra and
    makes a commanded tilt do something other than tilt the surface the ball
    is on. Kept because the tidier algebra is what will argue for it again.
    - Non-absorbability stopped one step short. Under tilt the offset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
2026-09-04 Drop z_home = z_flat; restore z_home as the sixth sweep axis
    Documentation only. stewart/kinematics.py, stewart/geometry.py and
    test_kinematics.py are untouched; h_p keeps its name (open item 6, pending,
    with real call sites); notation.md sec.9's envelope slots are untouched
    (open item 8, a decision).
    Everything here is dated 2026-09-04 and reverses claims already dated
    2026-09-04. Nothing is silently overwritten: each reversal quotes what it
    replaces and says which reading is current.
    DECISION. z_home = z_flat is dropped. z_flat - the plate height at which
    the arms lie flat with rods attached - stays an assembly datum and is no
    longer identified with home. Propagated everywhere the o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
2026-09-05 Add envelope diagnostics: azimuth range, z_home brackets, branch re-run
    Four modules under stewart/diagnostics/, numpy only, each runs as
    python -m and exits 0. No production code touched.
    envelope.py the settled envelope + the recovery model, computed
    rather than typed. Single source of truth; every
    other module imports the tilt limit from here so it
    cannot drift the way the provisional 6 degrees did.
    azimuth_symmetry.py (a) is a 60-degree azimuth window sufficient, and where
    zhome_bracket.py (b) lower bracket from N>0, (c) upper from |P|<=C
    branch_envelope.py (d) '-' branch re-run, (e) the -5.7e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
2026-09-05 Specify the working envelope, and propagate it through the documents
    test_kinematics.py untouched; h_p keeps its name; derivation sec.9 not
    touched; nothing renumbered.
    ENVELOPE, settled and now written down (notation.md sec.9, open item 8
    closed). dxy = dz = 0, yaw = 0, tilt limit 10.529 deg from bang-bang
    recovery - acc = 4 x0 / tau^2, sin(tilt) = 7 acc / (5 g), x0 = 50 mm
    working + 30 mm latency drift, tau = 0.5 s. Bare requirement 6.558 deg
    recorded alongside; the difference is named as the latency margin. Open
    item 1 closed by pointer.
    tau_L = 150 ms is flagged PROVISIONAL wherever it appears, with what it
    needs (s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
2026-09-05 Attribute the 177 empty z_home brackets; N_i > 0 does bind
    "N_i > 0 never sets the lower end, 0 of 363" was a SURVIVORSHIP sample.
    It ranged over candidates that HAVE a bracket - exactly the ones where
    the constraints did not cross - so it structurally could not contain a
    counterexample. A sample that could, does.
    The two constraints are different shapes, which fixes the categories:
    N_i > 0 is one-sided (a floor), reach is a two-sided interval. There is
    no N ceiling, so "reach floor above the N ceiling" cannot occur. Only
    "reach empty alone" (R) and "reach ceiling below the N floor" (X) exist.
    R 176 / 177
    X 1 / 177 beta=10, beta_p=55, r_p/r_b=1.10, a/r_b=0.10, d/r_b=0.80
    The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
2026-09-05 Correction pass: withdraw the attribution table, correct the N_i > 0 claim
    Documents and diagnostics only. stewart/kinematics.py, stewart/geometry.py
    and test_kinematics.py untouched, ik() docstring included.
    1. dxy VERIFIED, no leak. Every dxy in the repo is 0; notation.md sec.9's
    deleted note about translations carrying length dimension is still
    deleted - the only line matching it is the record OF the deletion.
    Nothing to revert. What replaces the non-zero dxy is recorded in the
    score-function plan line: translation sensitivity, delta-margin per unit
    normalised displacement at the tuned delta, a RANKING discriminator and
    not a feasibility test, probe 0.005-0.01 r_b.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
2026-09-05 Give code to the three numbers that only existed in prose
    Audit: of 102 distinct numeric literals added to docs/ today, 99 are
    printed by a committed diagnostic and 3 were hand arithmetic. New module
    stewart/diagnostics/sweep_budget.py, numpy only, exits 0, covers all
    three. This project has three recorded instances of a documented result
    with no committed code and one near-miss recovered from a scratchpad;
    arithmetic in prose is the same failure in a smaller size.
    1. COMPUTE LEDGER. 15625 candidates, ~2.7M full, ~4.9e8 cheap, ~3.9 GB.
    The GB figure carries a harness REQUIREMENT (chunk over candidates), so
    it is not a throwaway. Computed from the committed envelope constants,
    w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
2026-09-05 Implement fk() and the round-trip gate; the gate passes
    The gate passes: worst round-trip translation error 1.85e-13 mm, worst
    geodesic rotation error 2.09e-06 deg (the metric's floor, not the solver's),
    over 14436 poses across 4 geometries, seeded HOME, with 0 non-convergences and
    0 different-mode returns. Full report in docs/cc-fk-gate.md.
    The four settled decisions are taken as given. No rotation convention is
    introduced - the rotation-vector parameterisation needs none, so derivation
    sec.6 stays open. ik, stage1, legs, arm_tips, w and the geometry are
    untouched.
    JACOBIAN. The handed-over form was CORRECT and was not changed:
    df_i/domega = -e_i^T [R p_i]_x under the left perturbatio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
    [kinematics.py, roundtrip.py]
2026-09-05 Record the fk gate in the design log
    Skeleton entry under 5 September, same terms as the entries above it: facts and
    residuals, TODO(him) markers on the reasoning, nothing written in his voice.
    Source is docs/cc-fk-gate.md.
    Covers the gate result, the Jacobian verification and its negative control, the
    acceptance-not-stopping tolerance finding, the conditioning numbers with the
    characteristic length left open, the assembly-mode probe, the refinement
    question, and the six stale items found on the way.
    "Where Phase 0 stands" is left unedited and flagged TODO(him): rewrite - it
    names the branch rule as the immediate open question, which was fixed on
    2026-09-04, and lists the forward kinematic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
2026-09-07 Fix the rotation metric, settle (R, T), reclassify the near-mode case
    Three corrections to the 5 September gate work. The gate still passes; none of
    the three changes the verdict.
    METRIC FIXED, NOT ANNOTATED. arccos((tr - 1)/2) is replaced by
    |log_so3(R_cmd^T R_fk)| - same quantity, no floor. Near the identity
    tr(R) = 3 - theta^2 + O(theta^4), so the trace carries the angle only at second
    order and an O(eps) trace error becomes O(sqrt(eps)) in the angle: floor
    sqrt(2 eps) = 1.21e-06 deg predicted, 2.41e-06 measured. The antisymmetric part
    is linear in the angle and has none. Worst gate rotation error was reported
    2.091e-06 deg and is actually 7.820e-14 - 2.7e7x lower. Worst |dT| uncha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
    [kinematics.py, roundtrip.py]
2026-09-08 Add the tilt-limit and box-boundary probes
    tilt_bracket.py: re-runs zhome_bracket's 540-candidate screen and
    score_discriminators' constrained tune at tau_L = 75/150/300 ms
    (tilt 8.5383/10.5290/14.5520 deg), to find out whether anything
    downstream of the provisional tau_L depends on it being right.
    The envelope is not changed: the limits come from envelope.tilt_for
    called with a different x0, and the limit is rebound for the duration
    of a pass. Feasible set 425/363/259 of 540; a/r_b ordering holds at
    all three; margin ranking rho 0.987 (down) and 0.959 (up) against the
    current limit. The 2026-09-05 R/X attribution does NOT hold: X is
    0/1/2 across the range, so the correction to "N_i > 0 is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
2026-09-08 Record the 2026-09-08 session: the objective is incomplete
    box_boundary.py is the session's main finding and the design-log entry's
    centre of gravity, recorded as an OPEN PROBLEM. Opening the sampled box
    does not bring the optimum off the boundary, it moves it further on:
    r_p/r_b runs to 0.10, the smallest value probed, margin climbing
    monotonically to 0.963815 with no turn; opening a/r_b alone moves the
    winner to 0.60 and drags d/r_b from 0.80 to 1.20. The corner (r_p 0.60,
    a 0.35, d 0.80) is withdrawn as an artifact of where the grid stopped.
    Diagnosis recorded, fix not proposed and options not chosen: margin
    measures distance from unreachability, not capability, so a platform ring
    shri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
2026-09-08 Make three diagnostics carry the 2026-09-08 withdrawals in their own output
    sweep_budget.py part3 printed the withdrawn k-dependence as live output on
    every run - the one site where the premise was executed rather than
    recorded, so it would keep reproducing itself into any future summary.
    The computation and the k = 0.5/1.0/2.0 table are KEPT and still computed,
    under a header that states the claim is MOOT as of 2026-09-08: the ball
    surface is a bought sheet decoupled from the anchor ring, so x0 = 80 mm is
    a property of the sheet, does not scale with plate size, and neither
    framing's k-dependence applies. Every row of the table is prefixed
    [MOOT], the withdrawn premise is named (the recover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
2026-09-08 Add tilt_authority.py: authority ranks WITH margin, it does not oppose it
    The proposed counterweight to the 8 September objective finding is
    REFUTED as a counterweight, and the objective stays open.
    alpha_span = max over legs of (max - min over the 29 envelope poses) of
    alpha_i, from ik(), at the delta tuned under the existing cap
    cond(J_fk) <= 1e6 at char_len = r_b. Authority is TILT_LIMIT_DEG /
    alpha_span - dimensionless, a gearing, and since the numerator is the
    same 10.529 deg for every candidate it is a fixed decreasing relabelling
    of alpha_span, so every rank statistic is identical up to a sign. Both
    signs are printed at every correlation. No servo travel figure is chosen
    and alpha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
2026-09-08 Evaluate the feasible set at r_p/r_b = 80/90, the asserted absolute scale
    Absolute scale was ASSERTED 2026-09-08: r_b = 90 mm from the print bed,
    r_p = 80 mm from the printed hub carrying the bought 220 mm sheet. So
    r_p/r_b is no longer a sweep axis, and nothing in the package had been
    evaluated near the ratio it fixes: the 540-candidate coarse grid samples
    0.60 / 0.85 / 1.10, every top-of-field result sat at 0.60, box_boundary's
    r_p ray ran DOWNWARD to 0.10, and the one nearby datum was cc-fk-gate's
    fixture F at 110/100.
    A sibling rather than an amendment to tilt_bracket. tilt_bracket's
    question is the tilt-limit sensitivity of the whole screen and it varies
    one thing; this varies a diff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
2026-09-09 Drop tau_L: re-screen at 6.558 deg and set the sweep ranges from the pull
    tau_L is DROPPED, not revised (asserted 2026-09-09). docs/hardware-pull.md
    sec.4 establishes that servo step response is unpublished by every candidate
    maker - all of them publish seconds-per-60-deg no-load speed, a slew rate, not
    a step response - and that the sensor cells publish a frame interval, which is
    a sampling period and not a sensor-to-pose latency. Neither term can be
    reconstructed, so the 30 mm latency drift and the 3.97 deg it carried are
    removed. This completes the 2026-09-03 withdrawal of the 300 mm/s figure
    tau_L inherited from.
    tilt_dropped.py - the feasibility screen re-run at the new limit.
    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
2026-09-09 Record the tau_L drop, r_p fixed, tilt-authority closed, and sweep ranges
    Documentation only. Eight items from the 2026-09-08 session, written up
    2026-09-09 as placement and wording against settled/asserted content —
    no new judgement made here.
    notation.md:
    sec.8 - p's denominator corrected: the "asserted r_b floor of 80mm" that
    produced p=0.004330 was r_p under the wrong name. r_b is fixed
    at 90mm; p recomputed = 0.3464/90 = 0.003849. 0.004330 kept,
    marked superseded, not deleted. Added: TIE_TOL=1e-12 is correct
    for the dxy=0 collapse and eight decades wrong as a tie
    threshold at dxy=p, where the ranking resolves to ~1.5e-4.
    se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
2026-09-09 envelope.py: derive TILT_LIMIT_DEG from X0_WORKING, not a stale literal
    TILT_LIMIT_DEG = tilt_for(X0_ENVELOPE) computed 10.5290 deg at x0 = 80 mm
    (50 mm working + tau_L latency drift). tau_L was dropped 2026-09-08
    (notation.md sec.9): docs/hardware-pull.md finds neither of its two terms
    reconstructable from published data, so the 30 mm has no basis. Changed
    to TILT_LIMIT_DEG = tilt_for(X0_WORKING) - the same call TILT_BARE_DEG
    already makes - so the limit derives from the model instead of sitting as
    a value that can go stale again. 10.5290 kept visible as a superseded
    comment naming the date and reason, not deleted. New value: 6.5580 deg.
    No other constant touched: X0_LATENCY, TAU_L, V_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
2026-09-09 Three consequences of b0703ab: repoint two assertions, fix a stale print
    1. tilt_bracket.py and tilt_dropped.py each asserted
    abs(reference_column - ENV.TILT_LIMIT_DEG) < 1e-9. That held only
    because the 150 ms / x0 = 0.080 reference column and the module
    constant were both tilt_for(0.080) by construction. b0703ab moved
    TILT_LIMIT_DEG to tilt_for(X0_WORKING) = 6.5580, so both assertions
    would now raise on any run.
    Repointed each at ENV.tilt_for(0.080) directly - the reference
    column's own definition - instead of at the constant. Tolerance
    unchanged (1e-9), assertion kept, one-line dated comment added at
    each site naming why. Neither module's downstream text is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
2026-09-10 Add the sweep harness: it runs, and it returns a tie set of one group
    The [CC] item Phase 0 has been building toward. Generates candidates over
    five axes, screens with the closed-form feasibility tests, tunes delta per
    candidate, scores the survivors at the build-error probe, and returns a
    ranked shortlist of tie groups.
    368,000 candidates screened, 327,604 feasible (89%), all 327,604 scored.
    Screen 1,547 s, tune + score 4,295 s. The tie set is identical at both
    housing bounds: one group, six candidates, a = 60.40 mm, d = 126 mm,
    |e| = 47.5 deg, z_home = 95.62 mm, margin(p) = 0.874876. Not empty.
    Nothing is chosen. No joint, no servo, no horn; the two housing-OD runs
    are reported apart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
2026-09-10 Bound beta, fix the grouping key, and correct the mirror diagnosis
    Three changes to the sweep; everything else unchanged. 368,000 screened,
    327,780 feasible (89.1%), all scored. notation.md not touched.
    1. beta is BOUNDED, reversing the decision to sweep it open. The interval
    [4.1380, 55.8620] deg is derived from the clearance - arc = r_b * gap,
    gaps 2 beta and 120 - 2 beta, required to clear the 13.0 mm largest
    published sub-micro CASE SIZE (pull sec.5) - not hardcoded. Both ends
    are checked and they are different collisions. The bound is PERMISSIVE:
    case size is the bare body, the installed footprint is unpublished and
    flanges and wiring only add to it, so this cann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
2026-09-10 Measure whether tau_min bounds a from above: it does not
    One measurement, stewart/diagnostics/tau_transmission.py, over the 2fee8b0
    feasible set (327,780 candidates, sweep-run.npz cache). notation.md not
    touched; no weight, score, or bound proposed.
    Question: the 2fee8b0 sweep returns a = 60.40 mm, the ProModeler ceiling,
    with beta bounded, so a is set by the catalogue rather than the analysis -
    the third axis after r_p and beta where the recorded objective
    incompleteness has surfaced. tau_i = |rod_i . tangent_i| / d is the
    natural transmission-degradation candidate; score_discriminators part (b)
    measured rho = +0.835 against margin, but over a/r_b <= 0.35, and the
    sweep now sits at 0.671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
2026-09-10 Two checks the normalised score cannot see: reach margin in mm, rod slenderness
    stewart/diagnostics/build_margin.py. Both owed since the score was fixed
    in normalised units. Against the 2fee8b0 shortlist - a = 60.40 mm,
    d = 126 mm, beta = 5/55 deg, beta_p = 52.5/7.5 deg, z_home = 95.625 mm, at
    r_b = 90 mm, r_p = 80 mm, h_p/r_b = 0.1, tilt 6.5580 deg. Both mirror
    members. Neither is a ranking; both are pass/fail. No rod, joint or
    servo chosen. notation.md not touched.
    Check 1 - reach margin: min(C_i - |P_i|) = 90.96 mm at the tuned delta,
    both members - 263x the 0.3464 mm RSS build-error stack (notation.md
    sec.8, transcribed not recomputed). PASS. Same computation on the next 7
    group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
2026-09-10 Document batch: rename h_p -> c_p, name rod_i/tangent_i, renumber the derivation, add Grubler, close fk()/(R,T) and the arccos floor, flag the pairing argument, point past the stale "Where Phase 0 st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
    Test suite run before committing, since the rename touches working code:
    test_kinematics.py ALL PASS (exit 0); demo.py exit 0, output byte-identical
    to before the rename. Both re-verified after every subsequent edit.
    1. h_p -> c_p, the one rename. stewart/geometry.py (platform_ring,
    make_geometry - parameter, docstring, body, assert) and
    test_kinematics.py's fixture key. stewart/kinematics.py checked, not
    assumed: confirmed no h_p call site, reads the offset only through
    geom.p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
    [geometry.py, roundtrip.py]
2026-09-13 Consolidate docs: archive superseded files, fold notation into derivation, add STATUS.md
    - Move the four session handoffs, cc-summary, cc-fk-gate, repo-inventory and
    notation.md to docs/archive/ (frozen).
    - Rename stewart-ik-derivation -> derivation, phase-0-design-log -> design-log,
    hardware-pull -> hardware.
    - derivation.md §1 is now the single current-definitions glossary.
    - STATUS.md replaces dated handoffs: result, settled decisions, open, next steps.
    - Rewrite README.md and update CLAUDE.md, which still described ik/fk as stubs.
    - Repoint doc paths in code comments and print strings; no logic changed.
    [geometry.py, kinematics.py, roundtrip.py]
2026-09-13 Archive the Phase 0 sweep; set requirements for the MG90S stock-horn design
    - Move stewart/diagnostics/ and docs/archive/ into a single top-level archive/;
    move the untracked sweep outputs there too.
    - STATUS.md: new direction (MG90S stock horn, simplest design that passes),
    pass/fail requirements R1-R5 derived from the ball, servo parameters to
    measure, and the gearing window they imply.
    - design-log.md: 13 September entry recording the change and its reasoning.
    - README/CLAUDE.md updated; CLAUDE.md now asks for design-log entries as work
    happens.
    [geometry.py]
2026-09-16 Bench-test the MG90S, set the spec, and pick a geometry that passes
    Measured one MG90S with a pointer rig and a new serial test sketch
    (firmware/servo_test): 0.087 deg/us, 4 us (0.35 deg) deadband, 530-2480 us
    of travel, 286 deg/s no load falling to 207 at 382 g.cm, 20T spline, horn
    holes 4.15-15.95 mm. Gear backlash is 1-2 deg free but NEGLIGIBLE under
    one-way preload, which the platform's own weight supplies - the difference
    between a design that cannot work and one that can.
    Requirements follow from that. R3 goes as 1/tau^3 and sets a floor on G,
    which caps r_p = a/G, so the old 0.5 s recovery forced a 22 mm anchor
    circle. Relaxing to tau = 0.7 s and e = +/-8 mm gives R1 >= 4.5 deg,
    R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
    [performance.py, servo_test.ino]
2026-09-17 Calibrate all six servos, add clearance checks, settle the geometry
    Travel ends measured on servos 2-6 (STATUS.md now carries a per-servo
    table): low ends 510-530 us, high ends 2480-2490, centres 1495-1505,
    deadband 4 us on every unit. The range all six reach is 530-2480, so
    550-2460 us = +/-83 deg drives the set - confirming the travel_deg the
    evaluator had been assuming from servo 1 alone.
    Two clearance checks in performance.py, because nothing modelled
    interference and that is how a platform that passes on paper binds on the
    bench. clearance() takes rods against rods and servo cases; horn_clearance()
    adds the printed horn extension, measured off the finished CAD at
    32.3 x 12 x 4.95 mm.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
    [performance.py]
2026-09-17 Refresh the README and clear stale open items
    The README still described the stock-horn design and said the geometry was
    being chosen; it now carries the chosen geometry, where the requirements
    come from, and performance.py and firmware/ in the layout.
    STATUS.md: drop the "no git remote" item (there is one) and a duplicate
    ball-joint line, and refresh the joint, horn-extension and bracket entries
    to what is actually outstanding.
2026-09-18 Fix the servo case model, set shaft height 30 mm, record the over-printed arm
    Body had the MG90S case 12.3 mm along the shaft, centred on it; the real case
    runs 35.3 mm back from the horn. Re-run clearances: horn-case 25.1 mm,
    rod-case 29.3 mm, and each pair's horns must face each other (cases pointing
    inward collide). Horn reach set to the measured 26.5 mm.
    Also: joint-play limit at r_b = 80 is 0.24 mm (the 0.28 figure was for
    r_b = 90), a sensitivity check on r_p / beta_p / d / delta / a, the base
    footprint against the print bed, shaft height 30 mm (bracket spec B7), and
    the over-printed horn extension in hardware.md section 12.
    [performance.py]
2026-09-18 Measure the servo and rod ends, design the brackets, place the base plate
    - MG90S case measured; Body and Horn now sit at their measured positions
    along the shaft. Each pair's horns face each other; delta = 0 is the only
    yaw with room.
    - a = 22.5 (the printed arm as made, over-printed on the stock horn).
    - Rod ends measured. Insert spacers either side of the ball give ~30 deg of
    bind, so the arm keeps a straight bolt (25.1 deg needed). The evaluator
    now checks that as-built bolt by default (Requirements.base_bolt). Every
    rod stays in compression under the platform's weight, so joint play is
    preloaded out.
    - C bracket specified and reviewed (hardware.md section 13); shaft heig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
2026-10-08 Add stage 1 control: calibration, joystick and one-DOF motion
    servo_cal zeros each arm and stores per-leg zero and direction in EEPROM.
    joystick.py runs the IK on the PC and streams pulse widths to the Arduino,
    which limits, ramps and fails safe to level. motion.py oscillates one DOF
    at a time. Fix the tilt_pose docstring: the low side faces the azimuth.
    [joystick.ino, joystick.py, motion.py, performance.py, servo_cal.ino]
2026-10-08 Assemble the platform, measure the envelope, first joystick run
2026-10-08 Add tilt_test.py to measure the plate's tilt against commanded
    r1 holds 4.5 deg toward every 30 deg of azimuth; r2 approaches a 3 deg
    target from both sides for repeatability and deadband. Readings from a
    level on the plate are logged to a CSV. Not yet run on the platform.
2026-10-08 Edit the drafted design-log entries toward the author's voice
    Cut one-line closers and not-X-but-Y contrasts from the 13 September to
    8 October entries, and move the travel_deg note next to the travel
    measurements it refers to. No numbers or decisions changed.
2026-10-08 Show the design and the base-plate layout in the README
2026-10-09 Add photos of the stage 1 build to the README
2026-10-09 Tidy for readers: archive the Phase 0 parts survey, reword the README, add a licence
    docs/hardware.md keeps only the arm, bracket and top-plate specs, renumbered
    1-3 with every reference updated; the 9 September survey moves to archive/.
    The README now opens on the built platform. STATUS records the servo
    controller as decided. Drop the stale end of the design log, move the leg
    diagram into docs/, and add an MIT licence.
